bigtreetech/BIGTREETECH-EZ-Driver/BIGTREETECH EZ5160RGB/Hardware/TOP-Pin.png

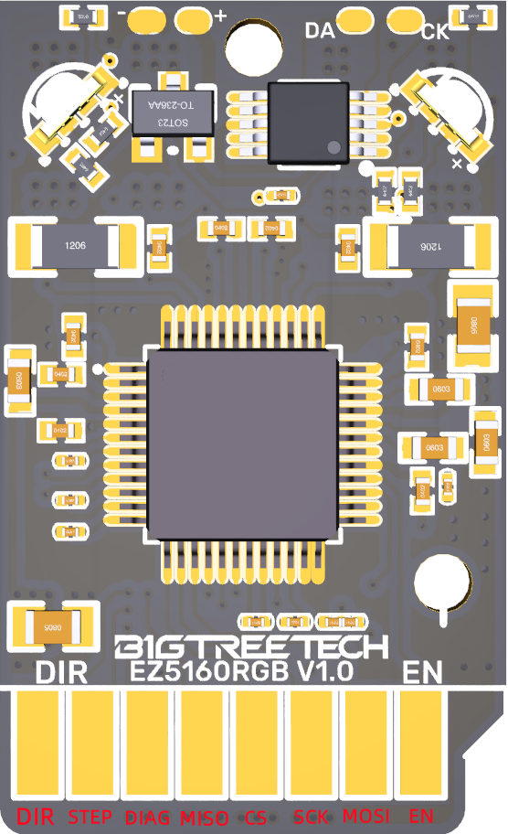
BIGTREETECH EZ5160RGB/Hardware/TOP-Pin.png
