bigtreetech/BIGTREETECH-EZ-Driver/BIGTREETECH EZ5160 Pro V1.0/Bot-Pin.png

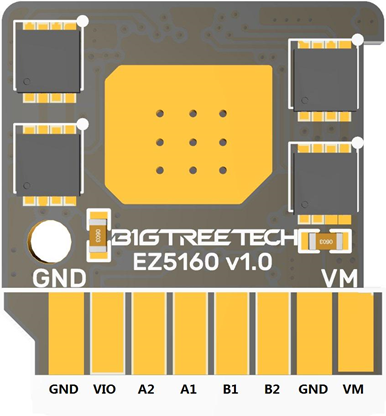
BIGTREETECH EZ5160 Pro V1.0/Bot-Pin.png
