bigtreetech/BIGTREETECH-EZ-Driver/BIGTREETECH EZ5160RGB/Hardware/BIGTREETECH EZ5160RGB V1.0用户手册.pdf

## 深圳市必趣科技有限公司 BIGTREETECH

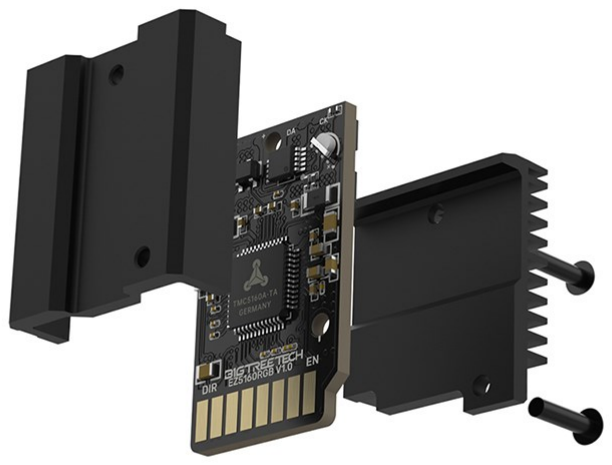
[picture p3: figure]

1 / 11

# BIGTREETECH

# EZ5160RGB V1.0

# 使用说明

## BIGTREETECH

2 / 11

目录

## BIGTREETECH

3 / 11

## 修订历史

版本 | 修改说明 | 日期
01.00 | 初稿 | 2023/04/15

## BIGTREETECH

4 / 11

## 一、产品简介

EZ5160 RGB 是一款大功率的步进电机驱动控制模块，外置 8 个功率 MOS 管，最大电压可 达 56V，支持的步进电机范围更广，适配性更高。

### 1.1 产品特点

1. 采用外置 8 个功率 MOS 管，可支持最大电压 VM=56V，最大电流 IRMS=4.7A，正弦波峰 值电流=6.6A；
2. 超静音模式；
3. 发热远远低于 2100、2130 等驱动；
4. 能防止电机抖动；
5. 不易失步；
6. 可驱动 57 步进电机；
7. 采用新研发的板框，匹配新的连接器，让客户体验美感的同时，避免旧驱动针脚扎伤 手的事故发生；
8. 采用新型定制的散热片，增强散热能力的同时，保护驱动芯片不受外部的伤害；
9. 板载 RGB 灯和热敏电阻测温，实时感知模块温度，并通过 RGB 灯状态传递温度信息。

### 1.2 产品参数

1. 外观尺寸： 18.5*30.47mm
2. 驱动芯片： TMC5160-TA
3. 输入电压（VM）： 8V-56V
4. 最大电流：4.7A，正弦波峰值电流 6.6A
5. 最大细分：256
6. 工作模式：SPI
7. R sensor: 50mΩ

## BIGTREETECH

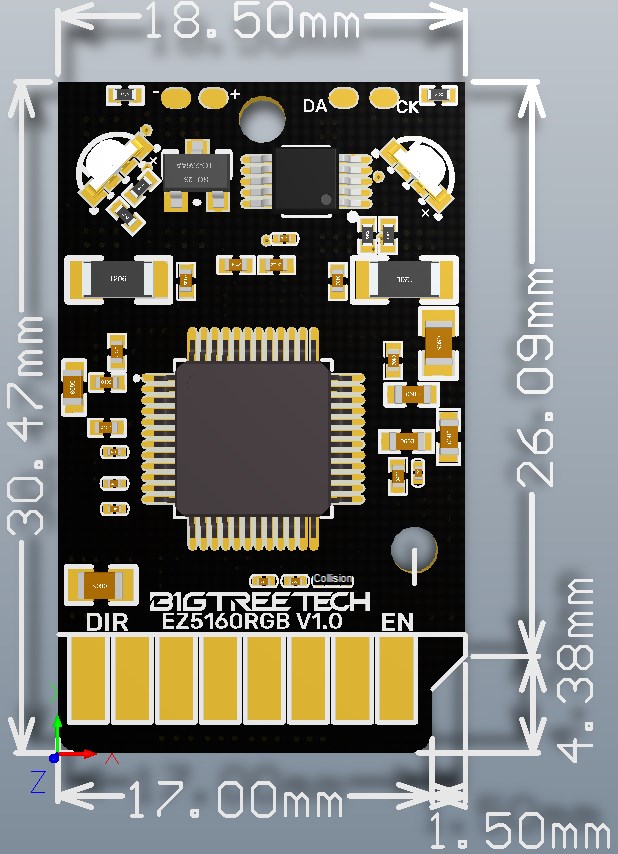
[picture p4: figure]

5 / 11

### 1.3 外设接口

### 1.3.1 尺寸图

## BIGTREETECH

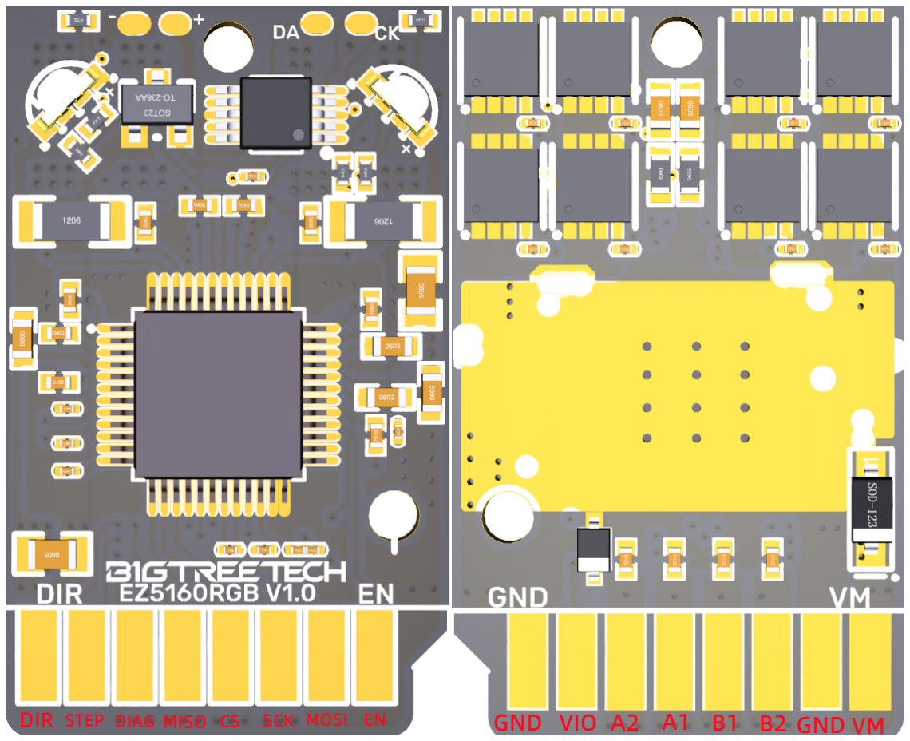
[picture p5: figure]

6 / 11

### 1.3.2 接口示意图

功能 | 功能
（EN）使能 | （VM）电机供电电压
（SDI/CFG1）数据 | （GND）接地
（SCK/CFG2）时钟 | （B2）B 相
（CSN/CFG3）片选 | （B1）B 相
（SDO/CFG0）数据 | （A1）A 相
（DIAG）堵转检测 | （A2）A 相
（STEP）脉冲输入 | （VIO）逻辑电压
（DIR）方向输入 | （GND）接地

## BIGTREETECH

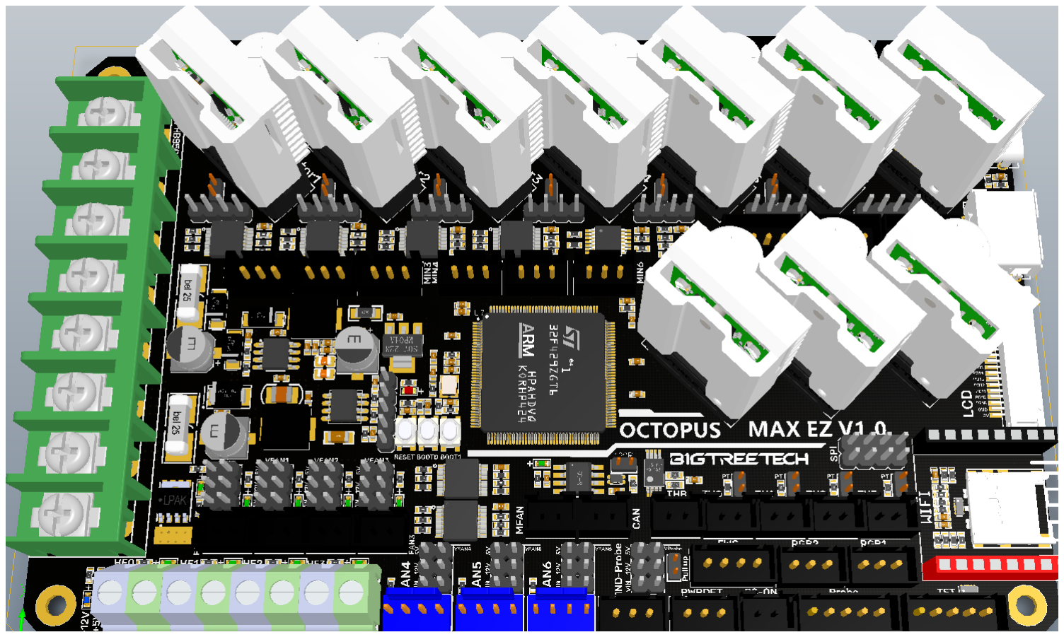
[picture p6: figure]

7 / 11

## 二、接口介绍

### 2.1 安装方式

EZ 版本驱动安装到新座子方向如下图所示（Octopus MAX EZ + EZ5160RGB）：

### 2.2 RGB 灯状态说明

温度处于 40°C 以下时，RGB 灯亮蓝色；
温度从 40°C 上升到 75°C 时，RGB 蓝色亮度逐渐减弱，红色亮度逐渐增强，色调由蓝色 渐变为紫色，然后渐变为洋红色；

温度处于 75°C 以上时，RGB 灯亮红色。

## BIGTREETECH

## 三、固件设置

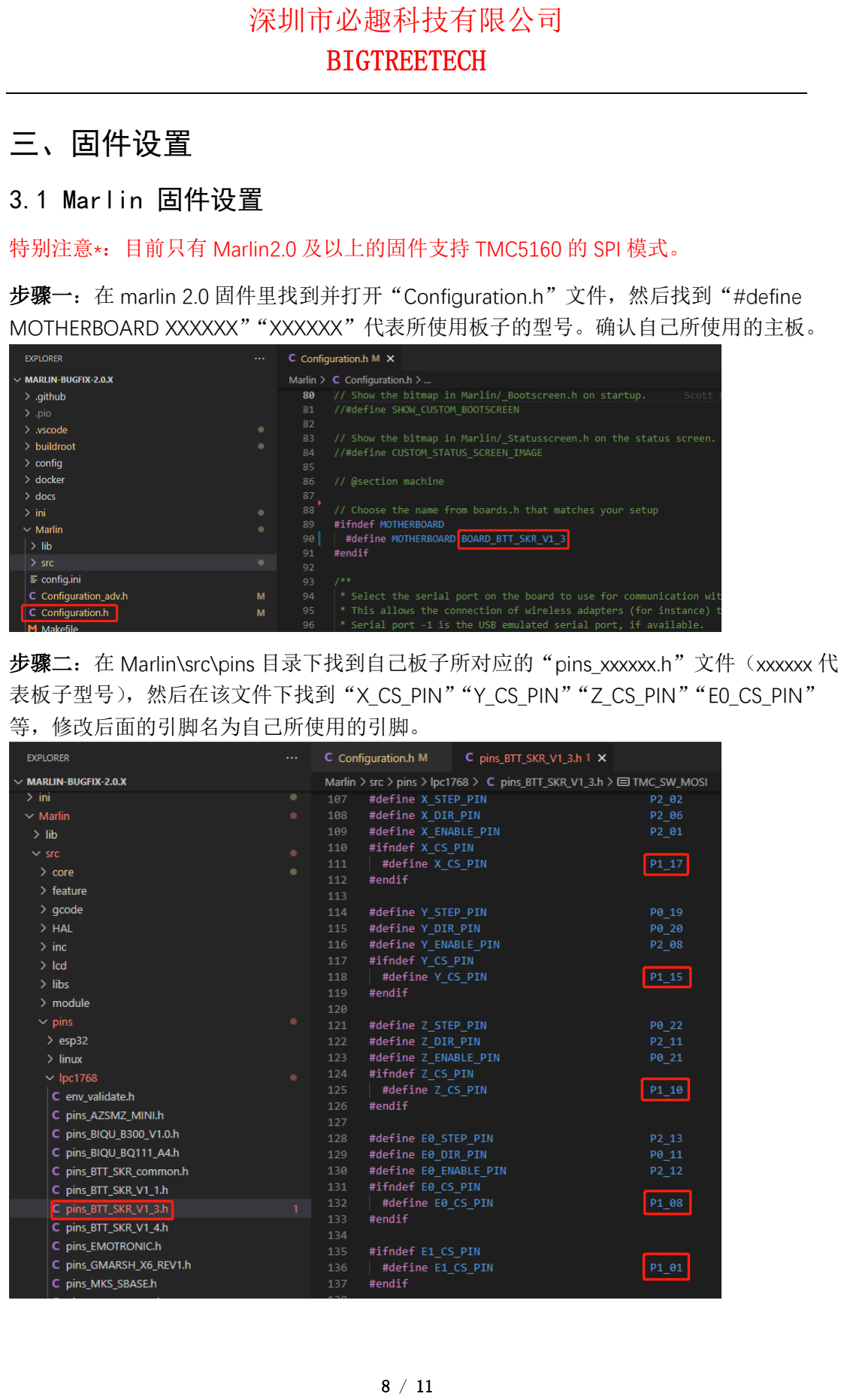
[picture p7: page 8]

8 / 11

### 3.1 Marlin 固件设置

特别注意*：目前只有 Marlin2.0 及以上的固件支持 TMC5160 的 SPI 模式。

步骤一：在 marlin 2.0 固件里找到并打开“Configuration.h”文件，然后找到“#define MOTHERBOARD XXXXXX”“XXXXXX”代表所使用板子的型号。确认自己所使用的主板。

步骤二：在 Marlin\src\pins 目录下找到自己板子所对应的“pins_xxxxxx.h”文件（xxxxxx 代 表板子型号），然后在该文件下找到“X_CS_PIN”“Y_CS_PIN”“Z_CS_PIN”“E0_CS_PIN” 等，修改后面的引脚名为自己所使用的引脚。

## BIGTREETECH

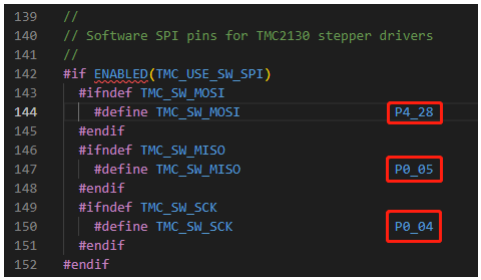
[picture p8: figure]
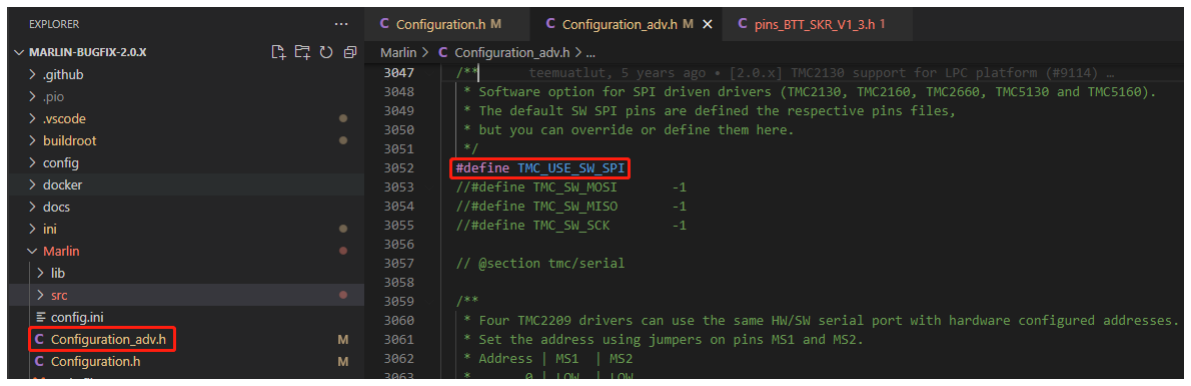
[picture p9: figure]

9 / 11

步骤三：在步骤二的文件下找到“#define TMC_SW_MOSI XXX”“#define TMC_SW_MISO XXX”“#define TMC_SW_SCK XXX”将“XXX”修改为自己所要使用的引 脚。

步骤四：找到并打开“Configuration_adv.h”,然后找到“#define TMC_USE_SW_SPI” 去 掉屏蔽符“//”

## BIGTREETECH

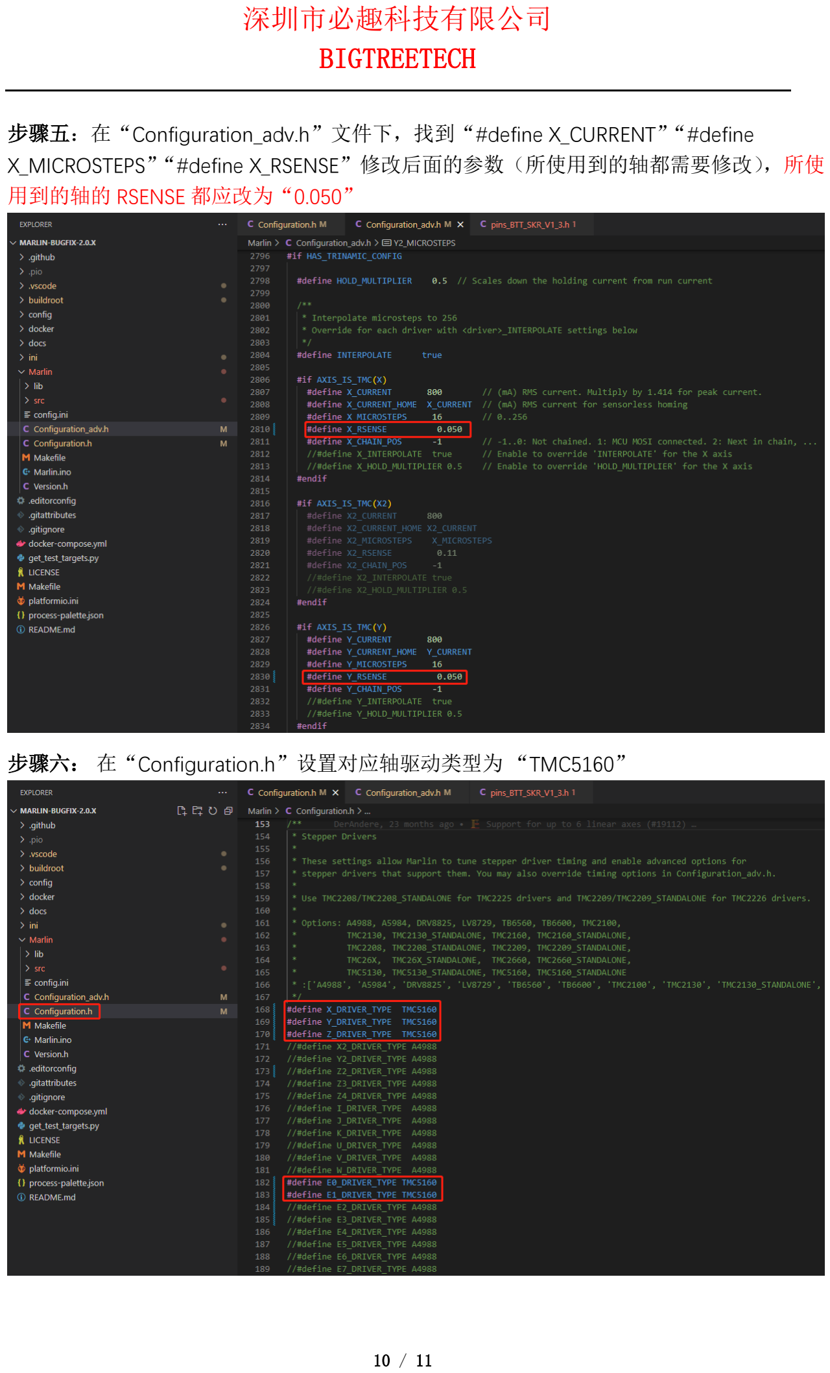
[picture p10: page 10]

10 / 11

步骤五：在“Configuration_adv.h”文件下，找到“#define X_CURRENT”“#define X_MICROSTEPS”“#define X_RSENSE”修改后面的参数（所使用到的轴都需要修改），所使 用到的轴的 RSENSE 都应改为“0.050”

步骤六： 在“Configuration.h”设置对应轴驱动类型为 “TMC5160”

## BIGTREETECH

11 / 11

### 3.2 Klipper 固件设置

[tmc5160 stepper_x]
cs_pin: P1.17
spi_software_miso_pin: P0.5 spi_software_mosi_pin: P4.28 spi_software_sclk_pin: P0.4 sense_resistor: 0.050
#diag1_pin: P1.29

run_current: 0.800
stealthchop_threshold: 999999
注意：Klipper 默认 sense_resistor 为 0.075，要设置为 0.050

## 四、注意事项

1. 安装驱动前一定要断开电源，防止驱动烧毁；
2. 请不要带电插拔驱动模块，以免造成损坏；
3. 我司出厂时已安装好散热片，请勿轻易拆除散热片，导热物质没有之后，散热效果会 降低；
4. 注意:使用高压（大于 48V）或者大电流（大于 2A）时，需采取主动散热以保证驱动可 以正常工作。

如果您还需要此产品的其他资源，可以到 https://github.com/bigtreetech/ 上自行查 找，如果无法找到您所需的资源，可以联系我们的售后支持。

若您使用中还遇到别的问题，欢迎您联系我们，我们定会细心为您解答；若您对我们的产 品有什么好的意见或建议，也欢迎您回馈给我们，我们也会仔细斟酌您的意见或建议，感 谢您选择 BIGTREETECH 制品，谢谢！
