bigtreetech/BIGTREETECH-EZ-Driver/BIGTREETECH EZ5160 Pro V1.0/Top-Pin.png

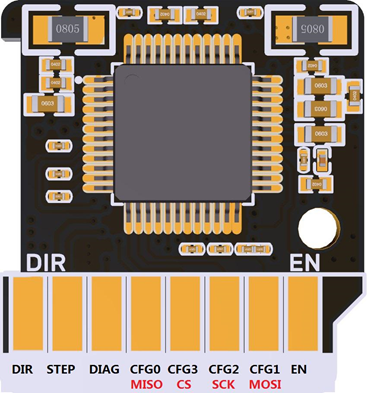
BIGTREETECH EZ5160 Pro V1.0/Top-Pin.png
