bigtreetech/BIGTREETECH-EZ-Driver/BIGTREETECH EZ5160RGB/Hardware/bot-Pin.png

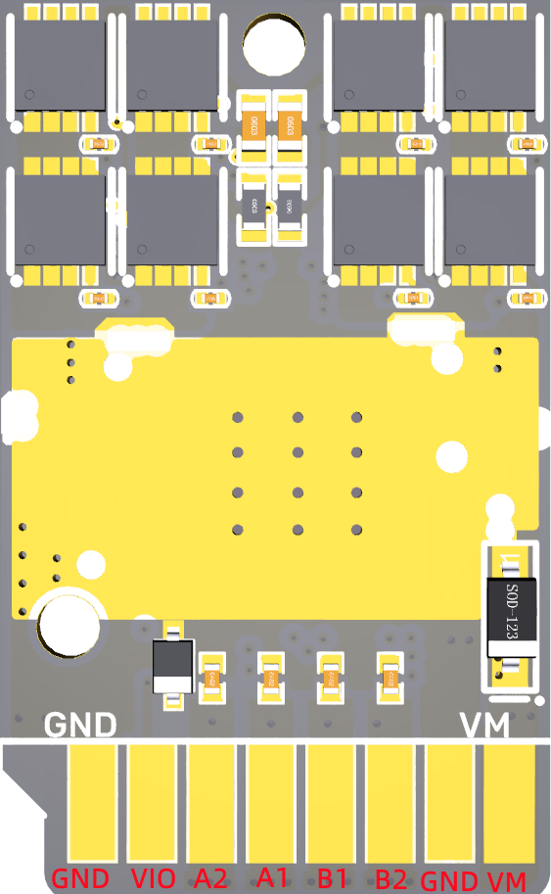
BIGTREETECH EZ5160RGB/Hardware/bot-Pin.png
