bigtreetech/BIGTREETECH-EZ-Driver/BIGTREETECH EZ2130 V1.0/3D/BIGTREETECH EZ2130 V1.0.step

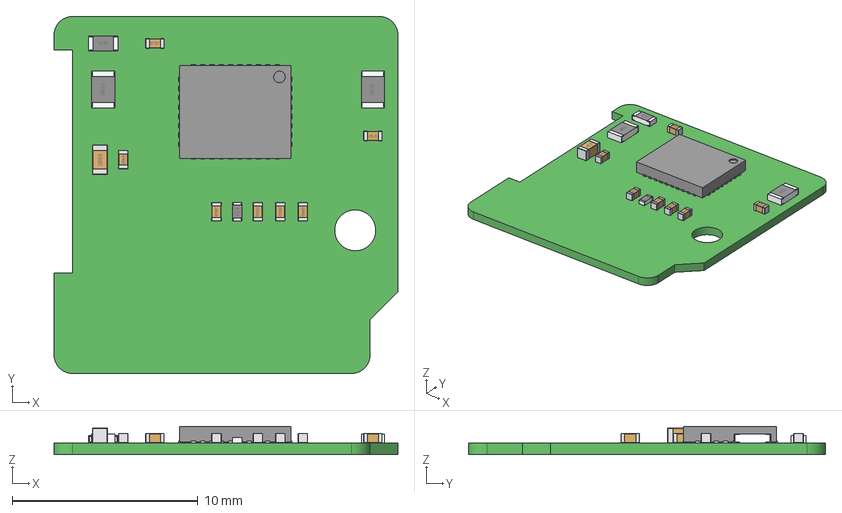
[picture p13: CAD file, 2022-06-20]
BIGTREETECH EZ2130 V1.0/3D/BIGTREETECH EZ2130 V1.0.step
18.5 x 19.2 x 1.52 mm
ThermalPin
PinsArrayLR
PinsArrayTB
R_0603
LOGO? x 12
R_0805 x 2
R_0402
C_0402 x 7
C_0603
