bigtreetech/BIGTREETECH-EZ-Driver/BIGTREETECH EZ2208 V1.0/BIGTREETECH EZ2208 V1.0.step

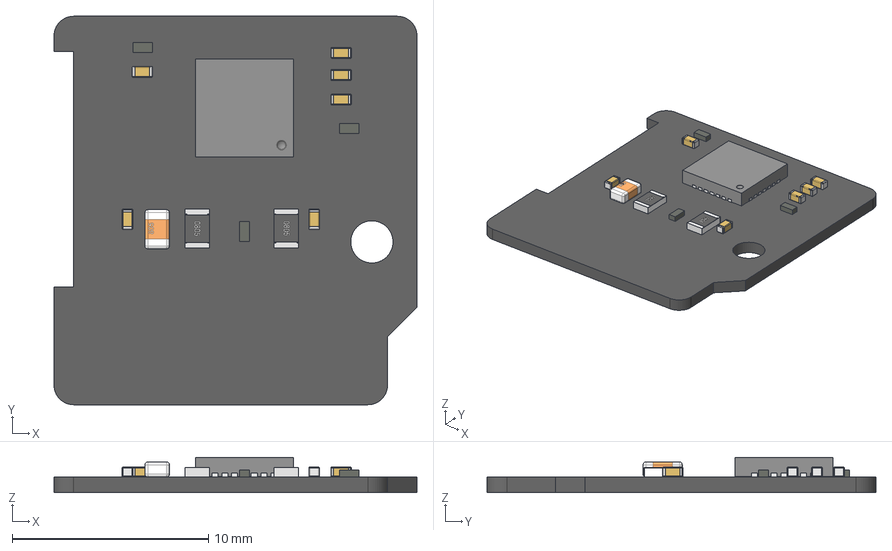
[picture p14: CAD file, 2022-06-20]
BIGTREETECH EZ2208 V1.0/BIGTREETECH EZ2208 V1.0.step
18.5 x 19.8 x 1.80 mm
Board
Open_CASCADE_STEP_translator_6.8_2.1.1 x 6
Open_CASCADE_STEP_translator_6.8_2.1.2 x 6
Open_CASCADE_STEP_translator_6.8_2.2.1 x 6
Extruded x 3
User_Library-0805_SMD_Capacitor
User_Library-R_0805 x 2
User_Library-QFN28-0_5_Fusion
User_Library-QFN28-0_5_Fillet
