bigtreetech/BIGTREETECH-EZ-Driver/BIGTREETECH EZ2225 V1.0/3D/BIGTREETECH EZ2225 V1.0.step

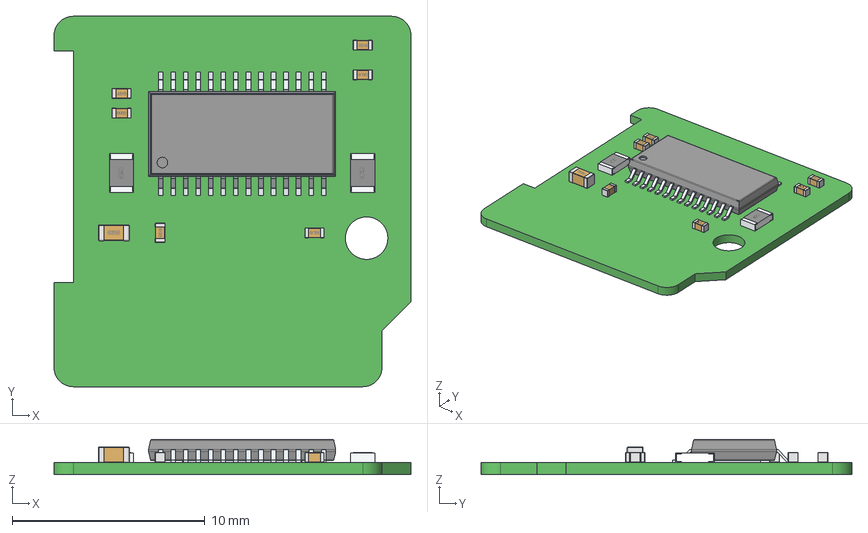
[picture p15: CAD file, 2022-06-20]
BIGTREETECH EZ2225 V1.0/3D/BIGTREETECH EZ2225 V1.0.step
18.5 x 19.2 x 1.82 mm
PinsArrayLR
ThermalPad
R_0805 x 2
LOGO? x 9
C_0402 x 6
C_0603
