bigtreetech/BIGTREETECH-EZ-Driver/BIGTREETECH EZ6609 V1.0/3D/BIGTREETECH EZ6609 V1.0.step

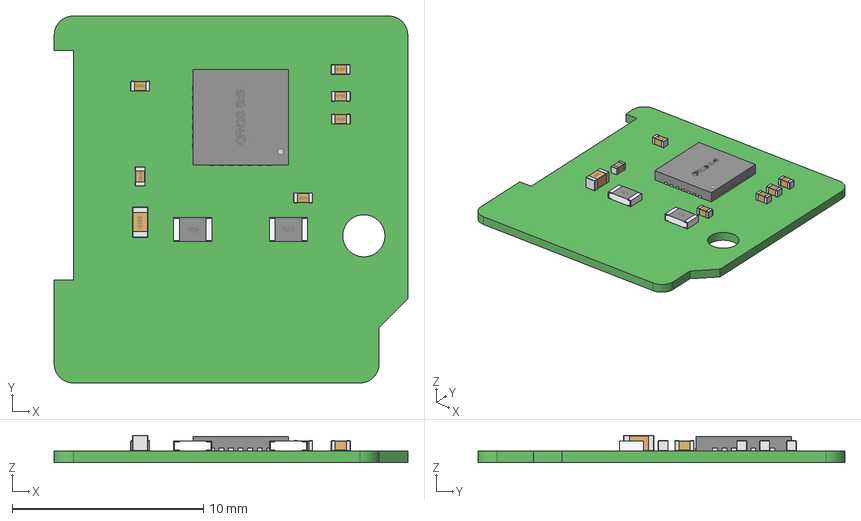
[picture p16: CAD file, 2022-06-20]
BIGTREETECH EZ6609 V1.0/3D/BIGTREETECH EZ6609 V1.0.step
18.5 x 19.2 x 1.43 mm
LOGO? x 9
C_0603
QFN28-5X5_呿极
QFN40_竘褐 x 64
LOGO?0.25
R_0805 x 2
C_0402 x 6
