bigtreetech/BIGTREETECH-EZ-Driver/(list of files, cad)

Other CAD files:
BIGTREETECH EZ2226 V1.0/3D/BIGTREETECH EZ2226 V1.0.step
BIGTREETECH EZZ2209 V1.0/BIGTREETECH EZ2209 V1.0.step
