bigtreetech/BIGTREETECH-EZ-Driver/BIGTREETECH EZ5160 Pro V1.0/BIGTREETECH EZ5160 V1.0 User Manual.pdf

## BIGTREETECH

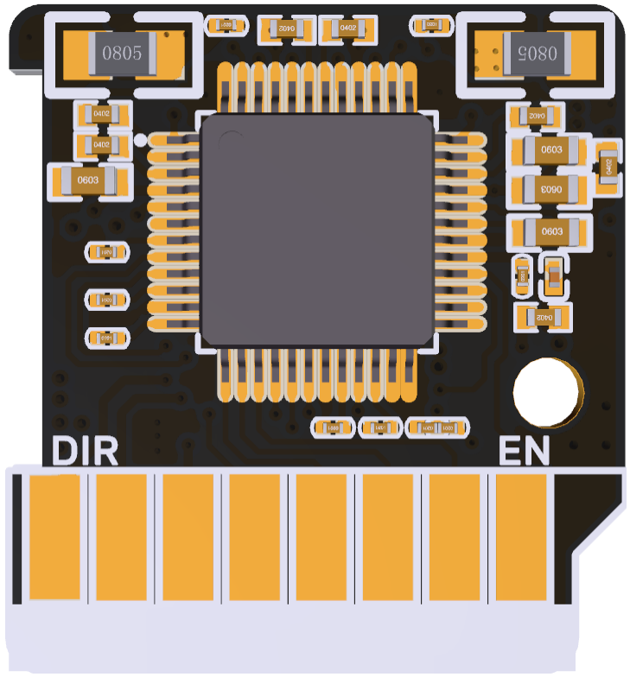
[picture p17: figure]

1 / 13

# BIGTREETECH

# EZ5160 V1.0

# User Manual

## Contents

## BIGTREETECH

2 / 13

Revision History | 3
1. Product Introduction | 4
1.1 Product Features | 4
1.2 Product Parameters | 4
1.3 Peripheral Interface | 5
1.3.1Product Dimensions | 5
1.3.2 Interface Diagram | 6
2. Interface Introduction | 7
2.1 Installation Method and Interface | 7
3. Firmware Settings | 8
3.1 Marlin Firmware Settings | 8
4. Precautions | 122

## BIGTREETECH

3 / 13

## Revision History

Version | Revision Description | Date
01.00 | First Draft | 2022/03/17

## BIGTREETECH

4 / 13

## 1. Product Introduction

TMC5160 is a high-power stepper motor drive control chip, with an external MOSFET, its maximum voltage can reach 48V, thus the supported stepper motor range is wider, and the adaptability is higher.

### 1.1 Product Features

1. With the external MOSFET, it can support higher voltage and larger current, and the maximum current can reach 8A (because the module is limited by size and connector, the current cannot exceed 3A);
2. Ultra-quiet mode;
3. Low heat generation, which is far lower than that of 2100, 2130, and other drivers;
4. It can prevent the motor from shaking;
5. Not easy to lose steps;
6. Can drive 57 stepper motors;
7. The newly developed board frame is used to match the new connector so that customers can experience the aesthetic feeling and avoid the accident of the old driving pin stabbing the hand;
8. Using a new type of specially made heat sink to enhance the heat dissipation as well as protect the driver chip from external damage;
9. Using the environmentally friendly packaging to improve the cost-effectiveness.

### 1.2 Product Parameters

1. Product Size: 18.5 x 20mm
2. Driver Chip: TMC5160-TA
3. Input Voltage (VM): 8V-48V
4. Maximum Current: 2.5A, Peak Value: 3A (the maximum current that the header can withstand.)
5. Maximum Subdivision: 256
6. Working Mode: SPI

## BIGTREETECH

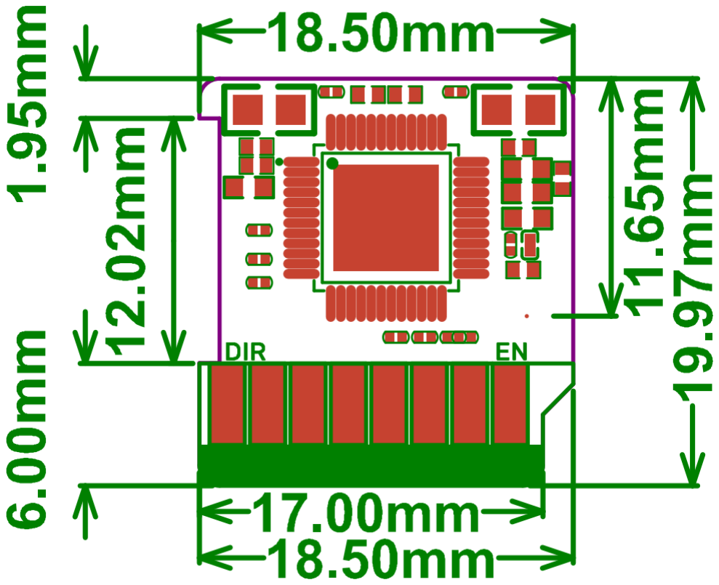
[picture p18: figure]

5 / 13

### 1.3 Peripheral Interface

### 1.3.1 Product Dimensions

## BIGTREETECH

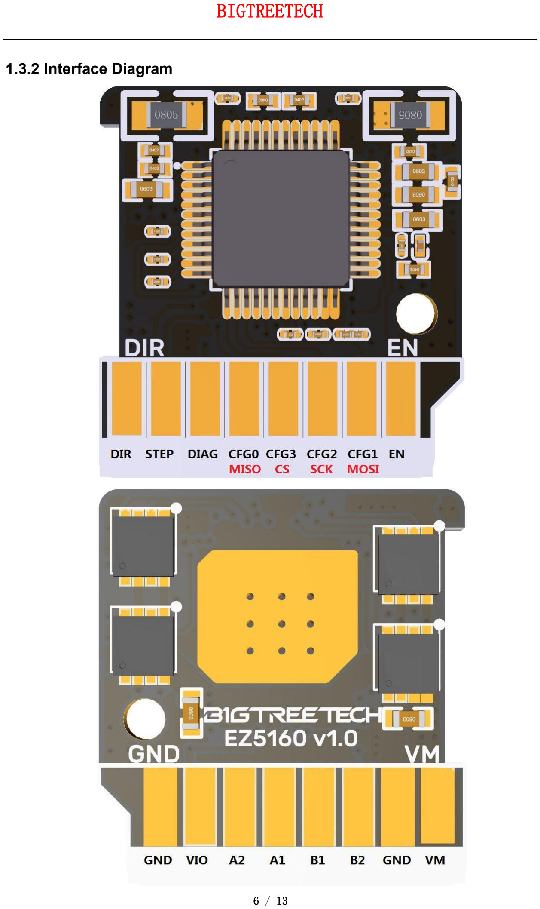
[picture p19: page 6]

6 / 13

### 1.3.2 Interface Diagram

## BIGTREETECH

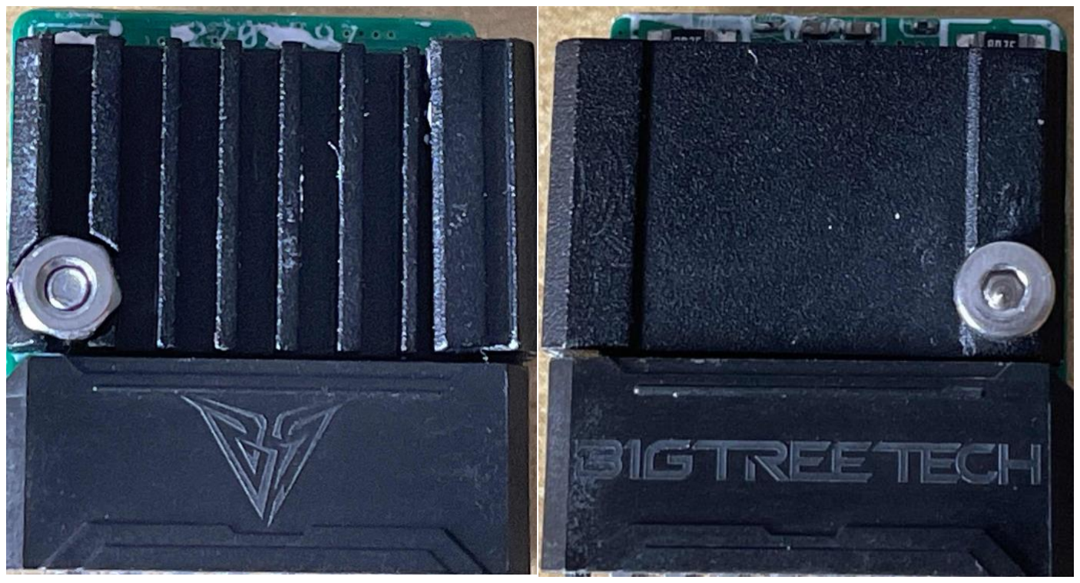
[picture p20: figure]

7 / 13

## 2. Interface Introduction

### 2.1 Installation Method and Interface

The direction of installing the EZ version driver to the new header is shown in the image below:

J1 | Function | J2 | Function
1 | (EN) Enable | 1 | (VM) Motor Supply Voltage
2 | (SDI/CFG1) Data | 2 | (GND) GND
3 | (SCK/CFG2) Clock | 3 | (B2) B Phase
4 | (CSN/CFG3) Chip Select | 4 | (B1) B Phase
5 | (SDO/CFG0) Data | 5 | (A1) A Phase
6 | (DIAG) Locked-Rotor Detection | 6 | (A2) A Phase
7 | (STEP) Pulse Input | 7 | (VIO) Logic Voltage
8 | (DIR) Direction Input | 8 | (GND) GND

## BIGTREETECH

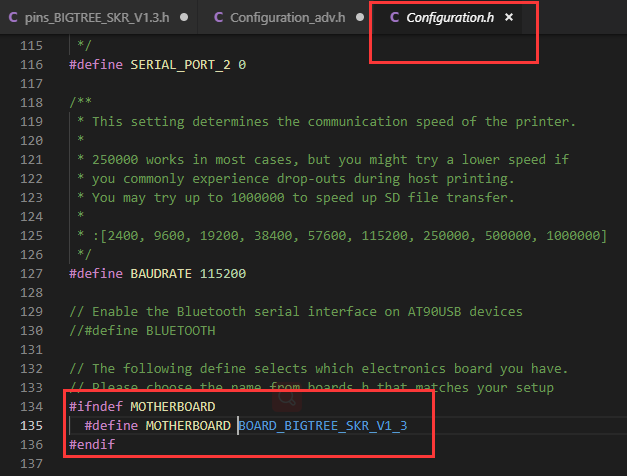
[picture p21: figure]

8 / 13

## 3. Firmware Settings

### 3.1 Marlin Firmware Settings

Note*: Currently only the firmware of Marlin 2.0 and later supports the SPI mode of TMC5160.

Step 1: Find and open the "Configuration.h" file in the Marlin 2.0 firmware, then find "#define MOTHERBOARD XXXXXX", "XXXXX" represents the model of the board used. Check the motherboard you are using.
Step 2: Find the "pins_xxxxxx.h" file corresponding to your board in Marlin\src\pins (xxxx represents the board model), and then find "X_CS_PIN", "Y_CS_PIN", "Z_CS_PIN", "EO_CS_PIN" etc., in the file, and modify the pin name to the pin you use.

## BIGTREETECH

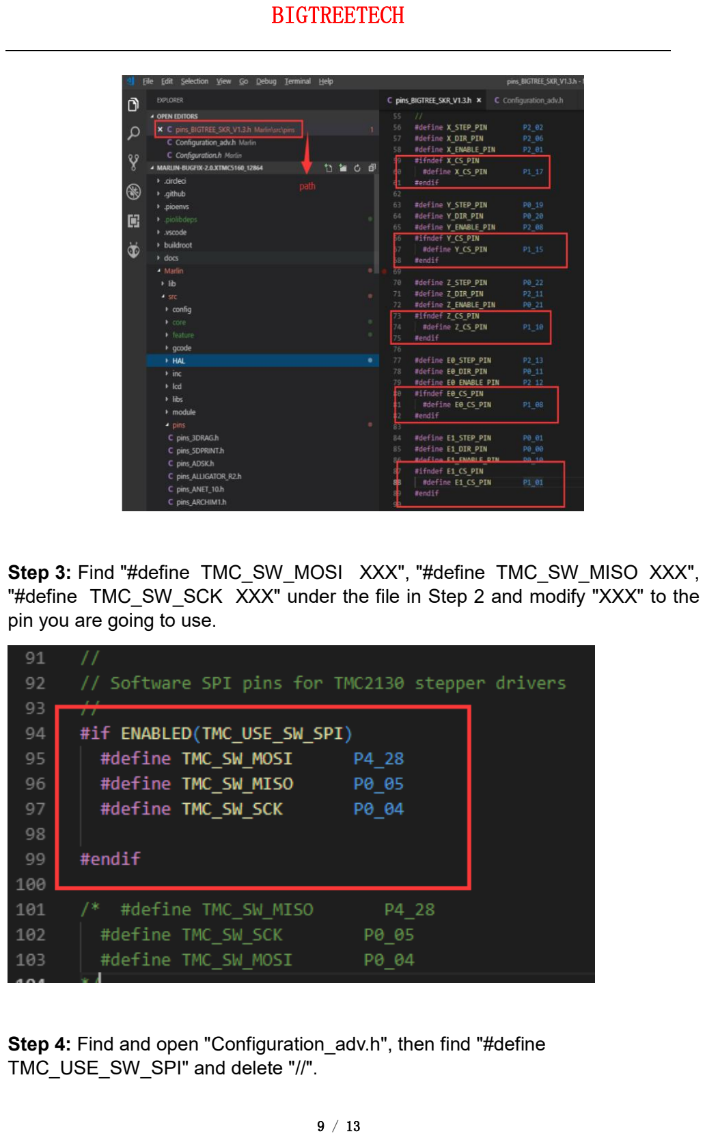
[picture p22: page 9]

9 / 13

Step 3: Find "#define TMC_SW_MOSI XXX", "#define TMC_SW_MISO XXX", "#define TMC_SW_SCK XXX" under the file in Step 2 and modify "XXX" to the pin you are going to use.
Step 4: Find and open "Configuration_adv.h", then find "#define TMC_USE_SW_SPI" and delete "//".

## BIGTREETECH

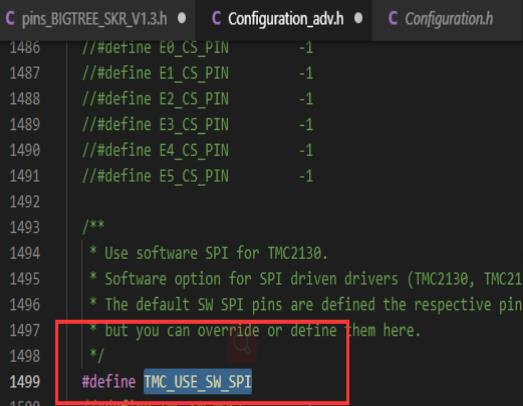
[picture p23: figure]

10 / 13

Step 5: In the "Configuration_adv.h" file, find "#define X_CURRENT", "#define X_MICROSTEPS", "#define X_RSENSE" and modify the following parameters, (all axes used need to be modified) the RSENSE of the axes used should be modified as "0.075".

## BIGTREETECH

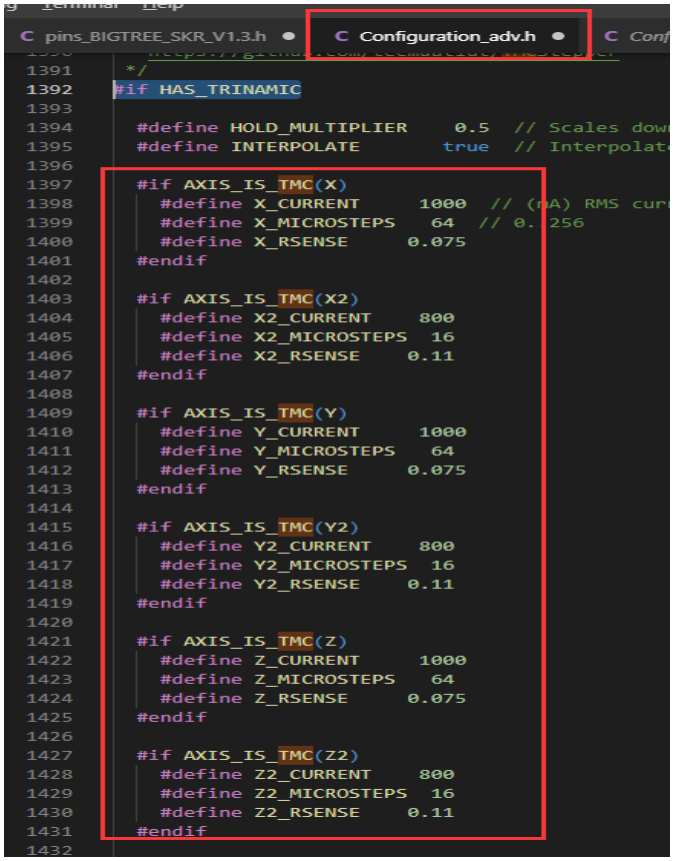
[picture p24: figure]

11 / 13

Step 6: After the modification of Step 5, find and open "Configuration.h" and then find "#define DEFAULT_AXIS_STEPS_PER_UNIT" and modify the following parameters to set the subdivision, the subdivision of this part must correspond to that of Step 5.

## BIGTREETECH

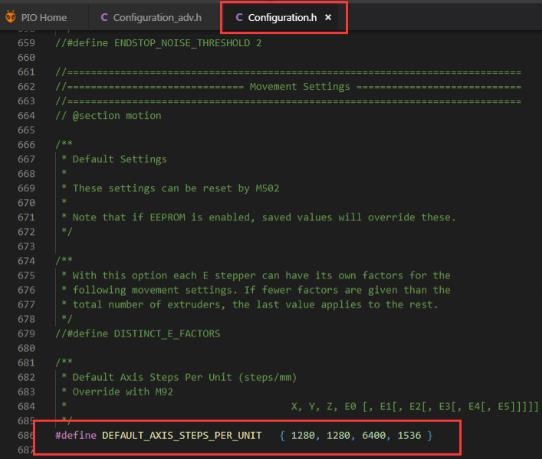
[picture p25: figure]

12 / 13

Subdivision Calculation Method: "80, 80, 400, 96" means 16 subdivision, if modified to 32 subdivision, that will be "80*(32/16), 80*(32/16) , 400*(32/16) , 96*(32/16) ".

The sampling resistance used in this product is 0.075R, so the effective value of the driving current of this product is 3A.

## 4. Precautions

1. Be sure to disconnect the power supply before installing the driver to prevent it from burning;
2. Before installing the driver, be sure to confirm the direction of the driver to prevent the driver from not working due to reverse connection;
3. Please do not plug and unplug the drive module with power on to avoid damage;

## BIGTREETECH

13 / 13

4. The product has installed the heat sink before leaving the factory， please don't remove it. If there is no thermal conductive material, the heat dissipation effect will be reduced；
5. Note: when using high voltage (more than 36V) or high current (more than 1.5A), active heat dissipation shall be taken to ensure that the drive can work normally.

For more information about this product, please visit https://github.com/bigtreetech/. If you cannot find the information you need, you can contact our after-sales support.

Please do not hesitate to contact us if you encounter other problems during use, we will answer your question carefully; Any suggestions/feedback on our products are welcome, and we will consider them carefully. Thanks for choosing BIGTREETECH.
