bigtreetech/BIGTREETECH-EZ-Driver/(threads)

Thread 1 (2022-07-14):

Lack of footprints for EZ Driver socket.

SteveJWallace, 2022-07-14:
There are no footprints available for the EZ Driver socket for KiCad or other EDA software. There are no specifications to use to create footprints from. This will prevent hobbyists from embracing the socket.

Fisheiyy, 2022-08-07:
I second this, a footprint for KiCad would be great.

Fisheiyy, 2022-08-07:
> There are no footprints available for the EZ Driver socket for KiCad or other EDA software. There are no specifications to use to create footprints from. This will prevent hobbyists from embracing the socket.

I created my own footprint/symbol for KiCad
[BTT_EZDRIVER_SOCKET.zip](https://github.com/bigtreetech/BIGTREETECH-EZ-Driver/files/9276693/BTT_EZDRIVER_SOCKET.zip)

Thread 2 (2022-09-07):

VS rail shorted to ground through MLCC.

BenChung, 2022-09-07:
I'm helping someone who observed a EZ2209 make a loud pop and emit flame while powered on by examining their EZ2209 to try and determine a root cause of the failure.

These images show the state of the driver after the heatsink was removed and initial cleaning:
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

Notably, the VS tracks have been largely vaporized with damage particularly on the pin 28 side of the board (towards the square cutout side). I further investigated C3 as a potential cause of the issue, as the positive side of the capacitor and its trace appears to have been completely destroyed with the opposing ground plane also blown off. The following image shows the state of C3 while in-situ:
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

Based on the apparent damage to C3 (missing a corner of the capacitor body besides the contact), I desoldered C3 and flipped it over to examine the corner that appeared to have been destroyed:

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

Considerable destruction of the capacitor body is observed. Note that the ground-side electrode separated from the MLCC while it was removed. In particular, the corner of the capacitor close to the camera exhibits considerable carbonization and is no longer geometrically intact. This supports a hypothesis that the failure was caused by a short to ground from VS through C3 caused by stress cracking originating at a corner of the VS side of the capacitor shearing the electrodes. Under this hypothesis, the damage to the capacitor (and the rest of the PCB) would be caused by the resulting large fault current as the motor capacitor discharging through the shorted electrodes in the capacitor, explaining the asymmetric damage to the capacitor centered near one of the contacts.

I suspect that this failure was caused by either mechanical force applied during assembly or through flexing of the PCB at some point during assembly, shipping, or installation. Based on this, redesign of the heatsink to redistribute mechanical loads away from the PCB, use of a flexible termination MLCC, or moving the MLCC away from potential load paths may address the issue.

Thread 5 (2023-09-12):

Reference of EZ driver connector

kingovchouffe, 2023-09-12:
I would like to had the EZ driver connector on my own PCB for a robot project, does it have a number part or manufactor reference ?

Thread 6 (2023-11-25):

How to disable DIAG pin

norston, 2023-11-25:
I'm pretty sure the DIAG pin on the EZ2209 driver is causing my endstops not to trigger (or stay triggered, depending on which state I choose (high or low), while using the internal pullup - Marlin fw). On your TMC2201V1.2 you talk about this exact issue and your solution is to cut the DIAG pin. I'm using an Octopus MAX EZ with your EZ2209 drivers, so there is no pin to cut. Any suggestions on how to disable this pin?
