bigtreetech/BIGTREETECH-EZ-Driver/BIGTREETECH EZ2225 V1.0/Hardware/BIGTREETECH EZ2225 V1.0-SIZE.pdf

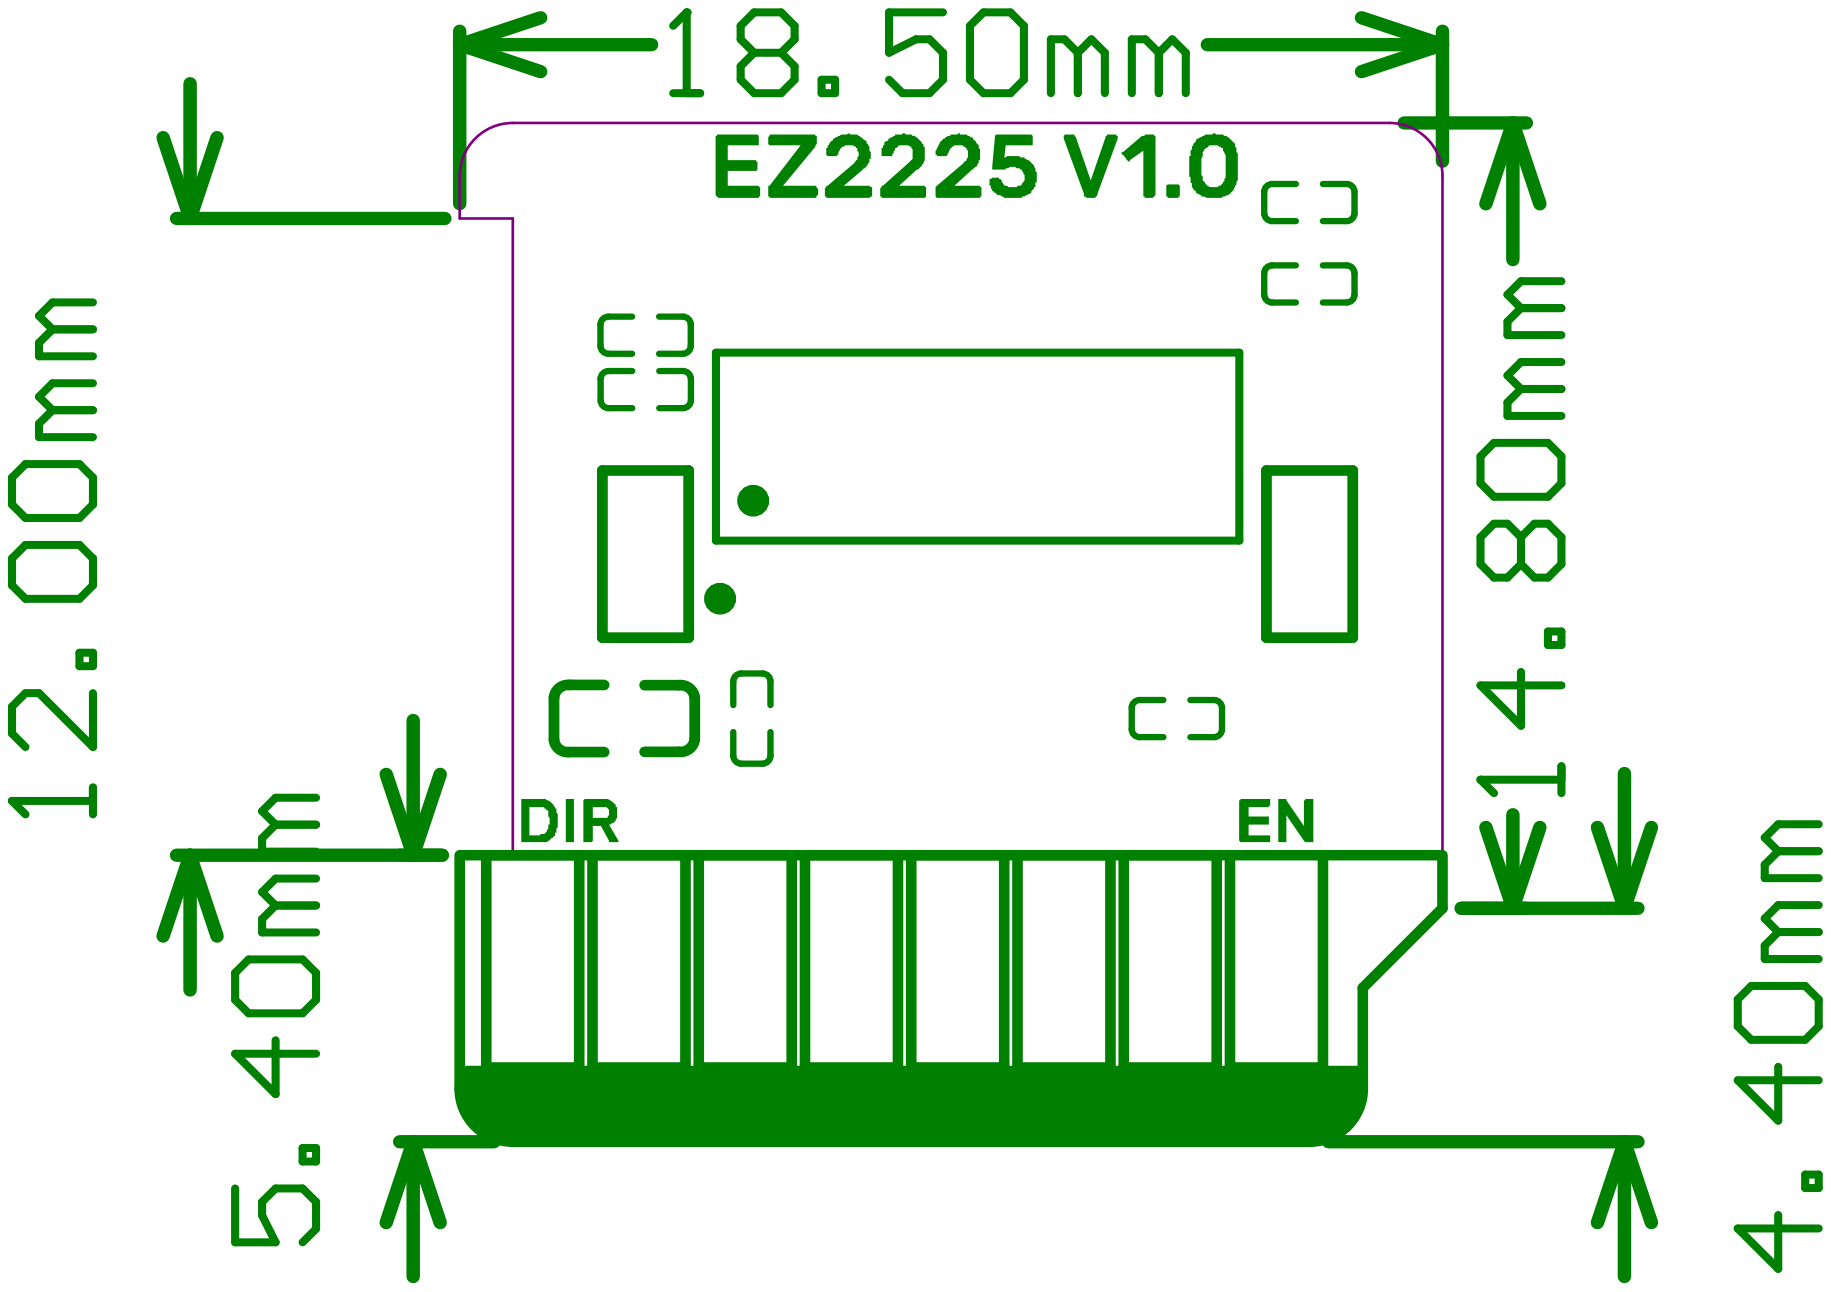
[picture p42: page 1]
