bigtreetech/BIGTREETECH-EZ-Driver/BIGTREETECH EZ2130 V1.0/Hardware/BIGTREETECH EZ2130 V1.0-SCH.pdf

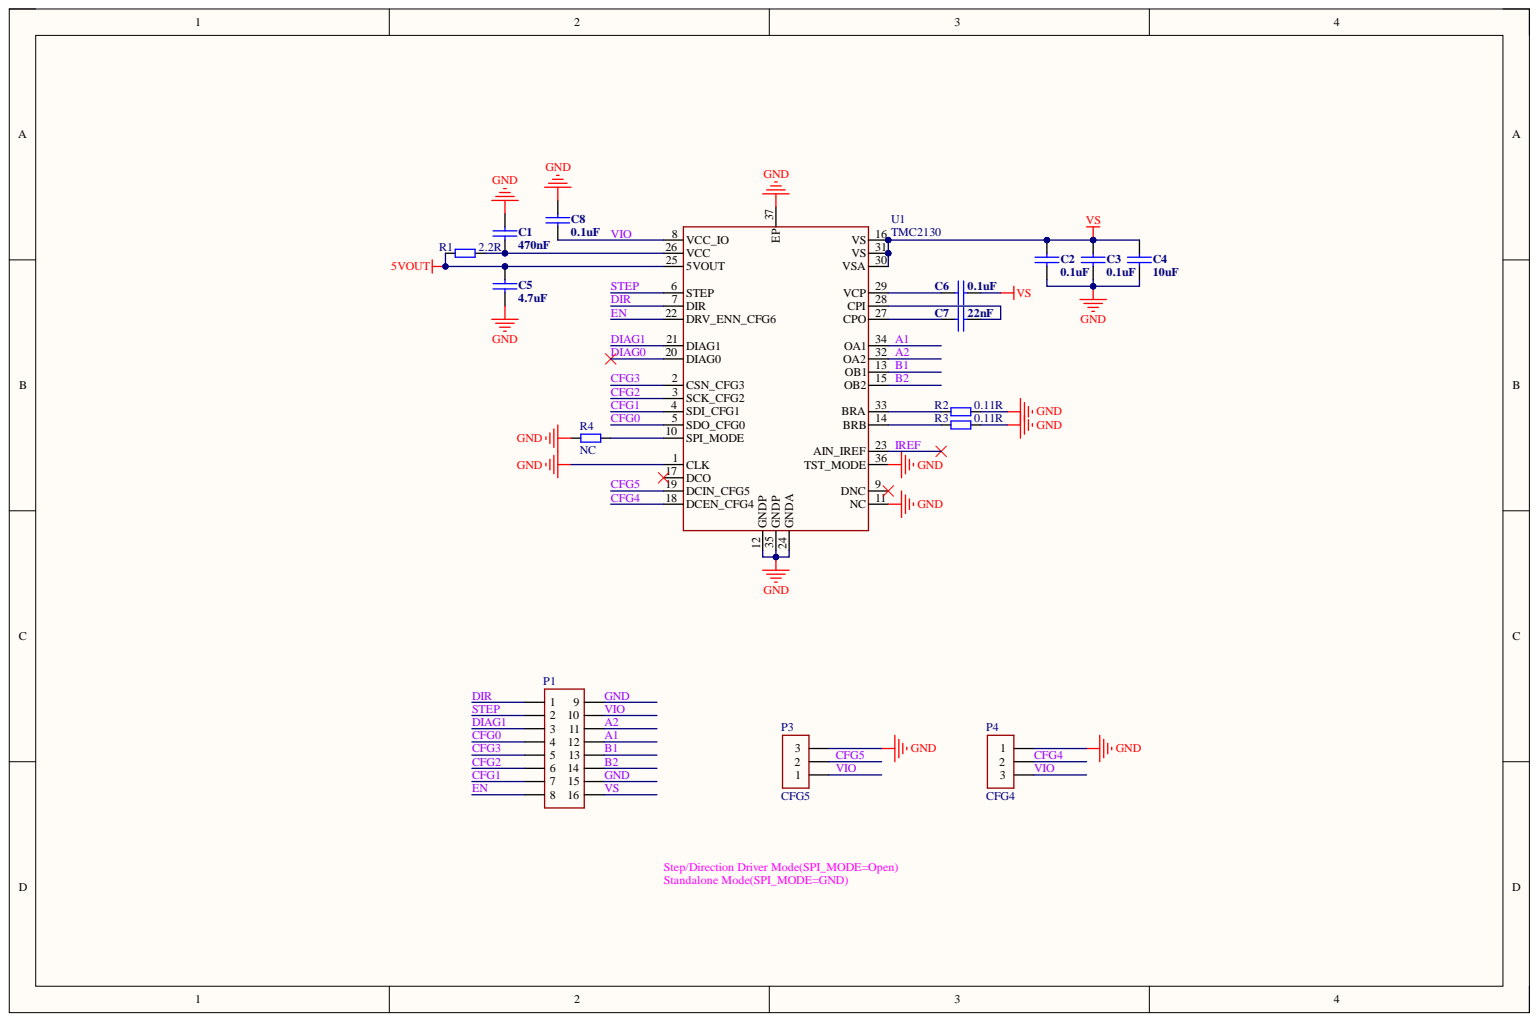
[picture p43: page 1]
