bigtreetech/BIGTREETECH-EZ-Driver/BIGTREETECH EZ2130 V1.0/Hardware/BIGTREETECH EZ2130 V1.0-SIZE.pdf

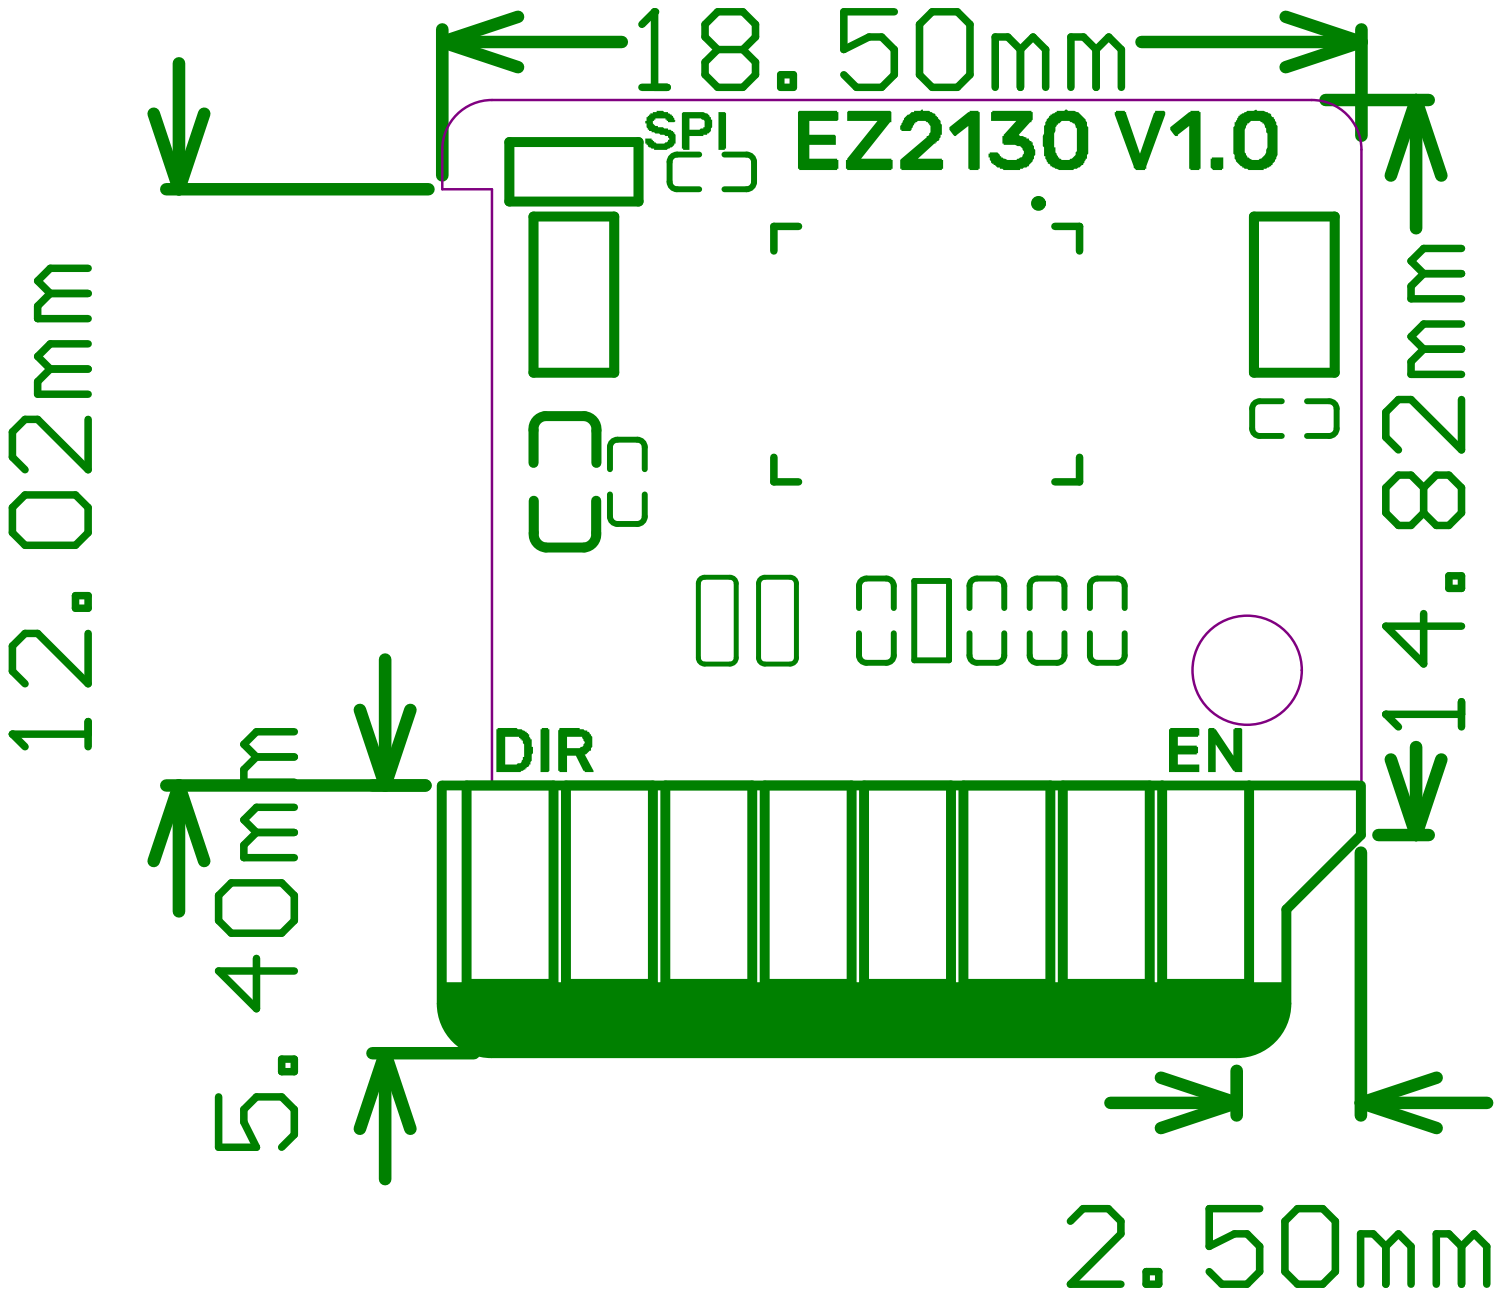
[picture p44: page 1]
