bigtreetech/BIGTREETECH-EZ-Driver/BIGTREETECH EZ5160 Pro V1.0/BIGTREETECH EZ5160 V1.0-BOT.pdf

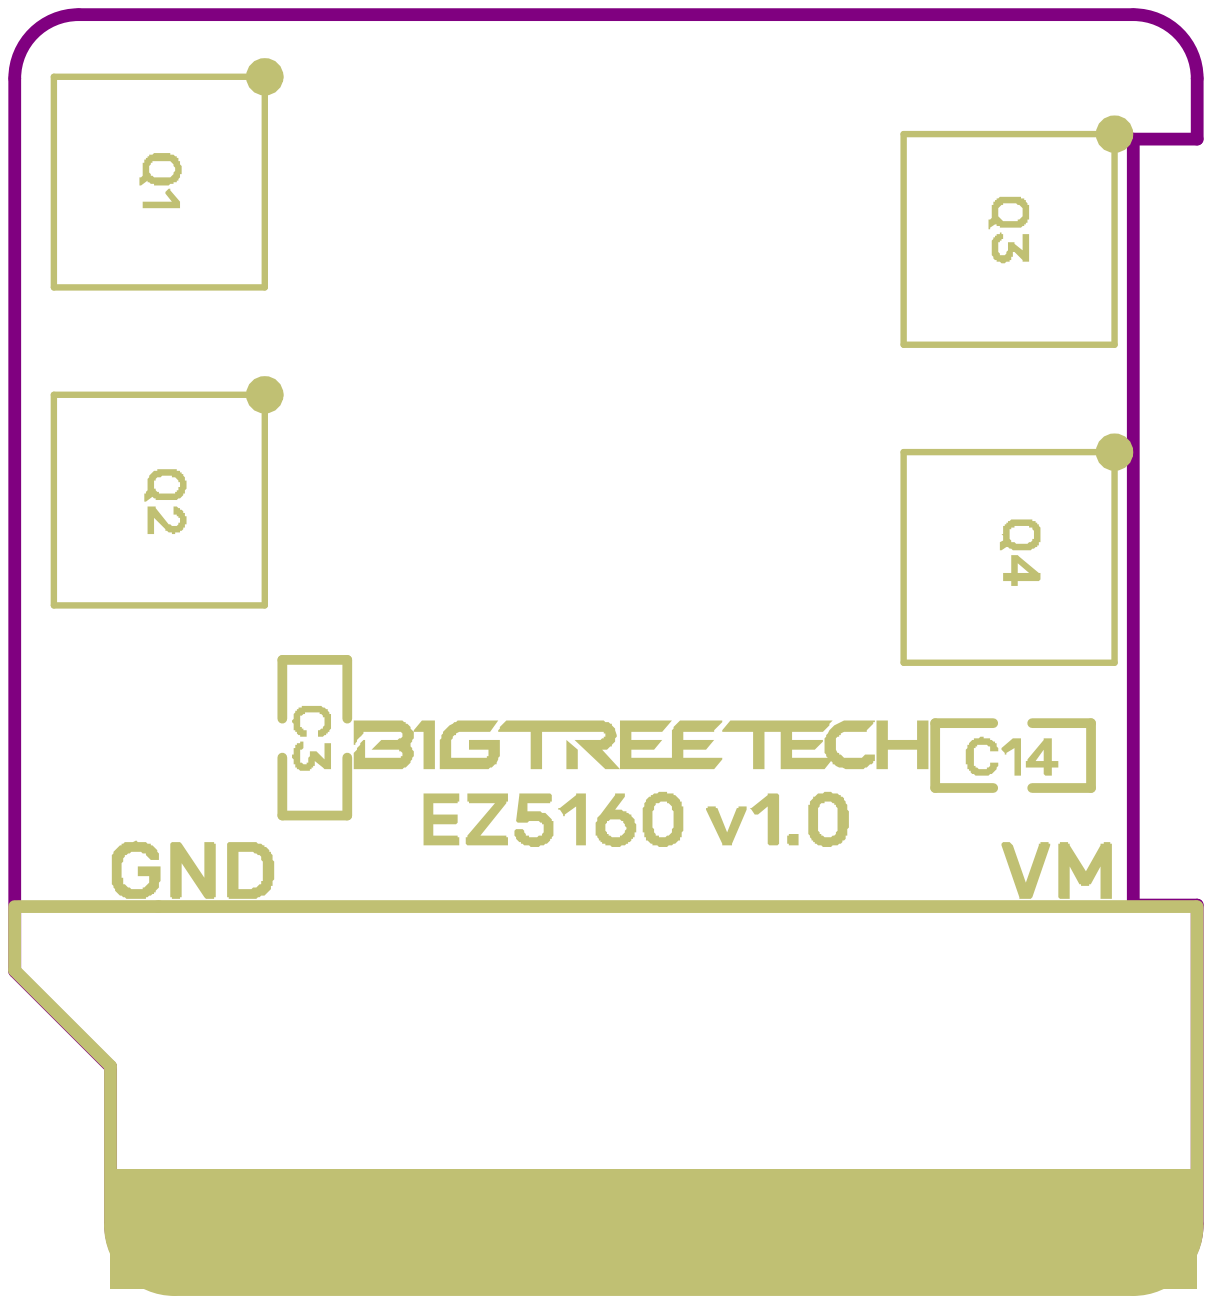
[picture p45: page 1]
