bigtreetech/BIGTREETECH-EZ-Driver/BIGTREETECH EZ5160 Pro V1.0/BIGTREETECH EZ5160 V1.0-SIZE.pdf

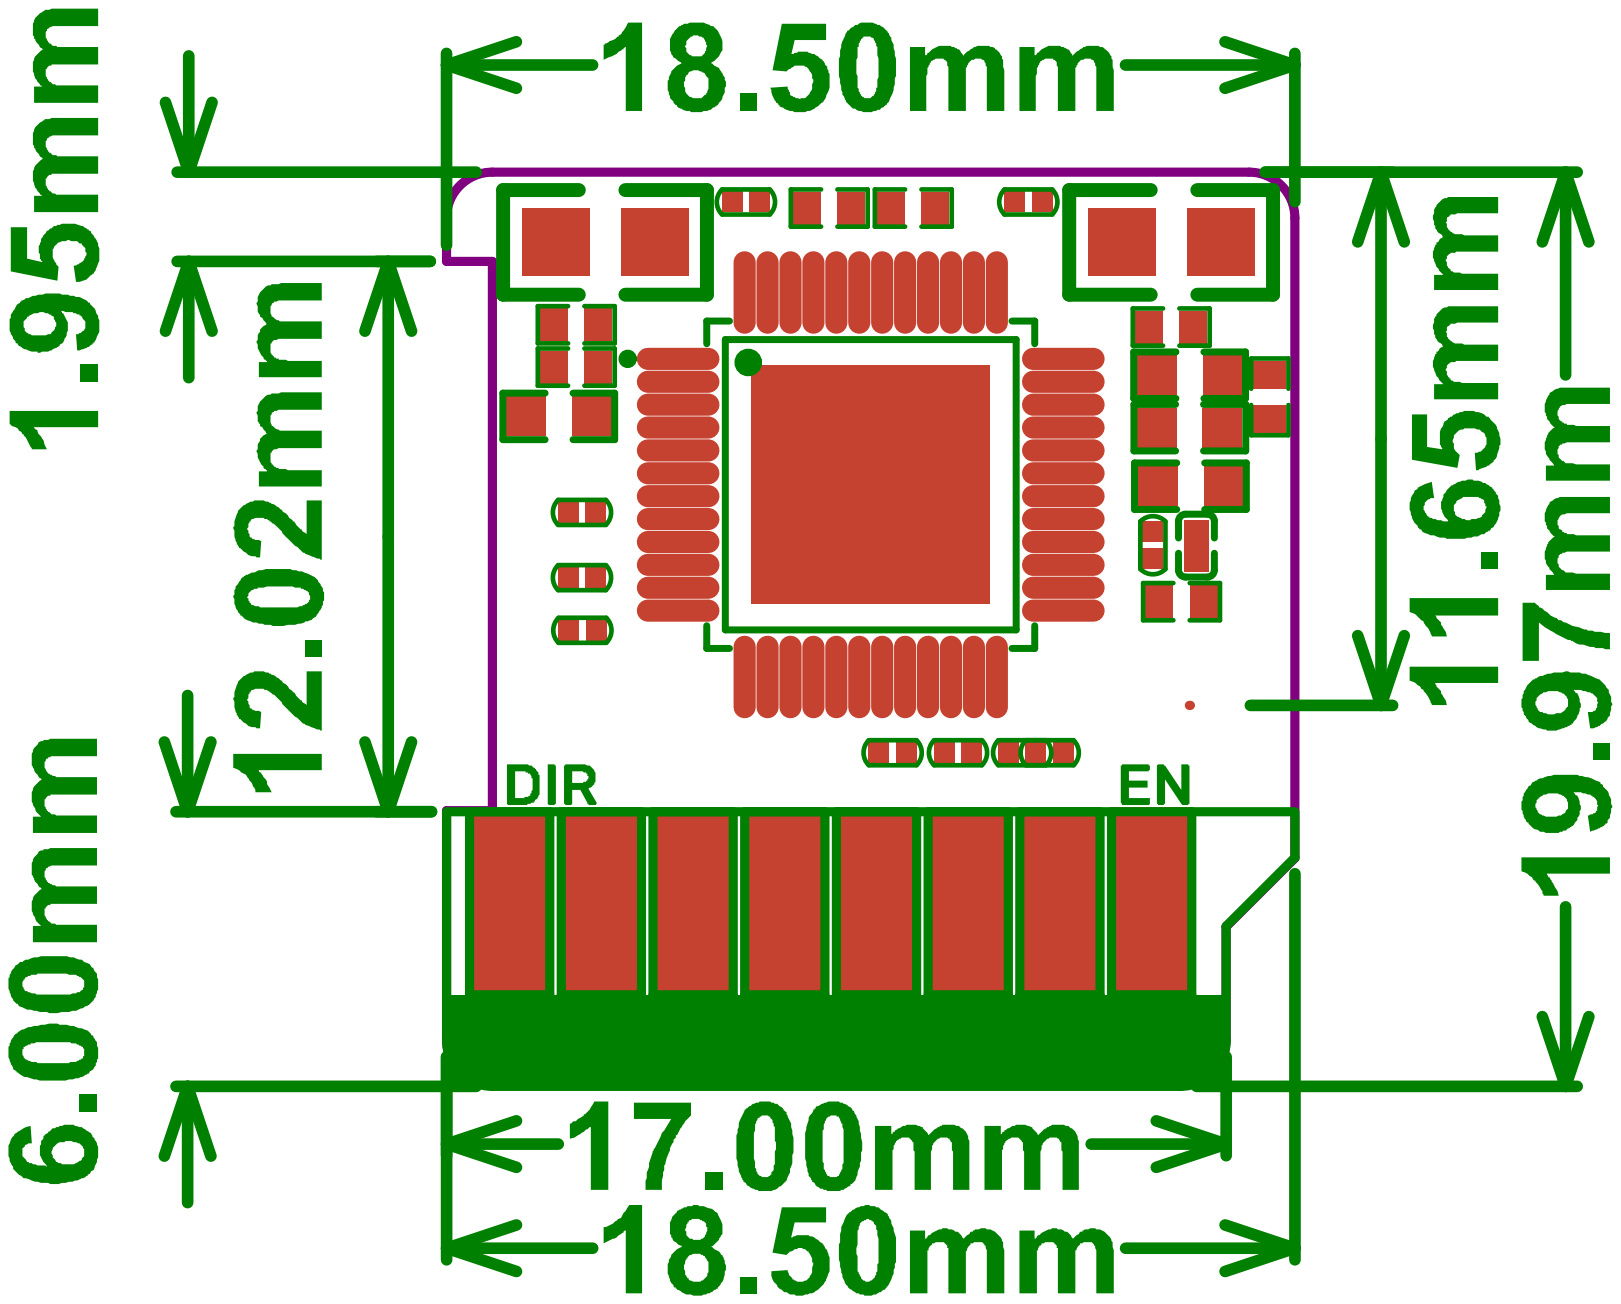
[picture p46: page 1]
