bigtreetech/BIGTREETECH-EZ-Driver/BIGTREETECH EZDriver Connector/BTT EZ-Driver Connector V1.0-bot.pdf

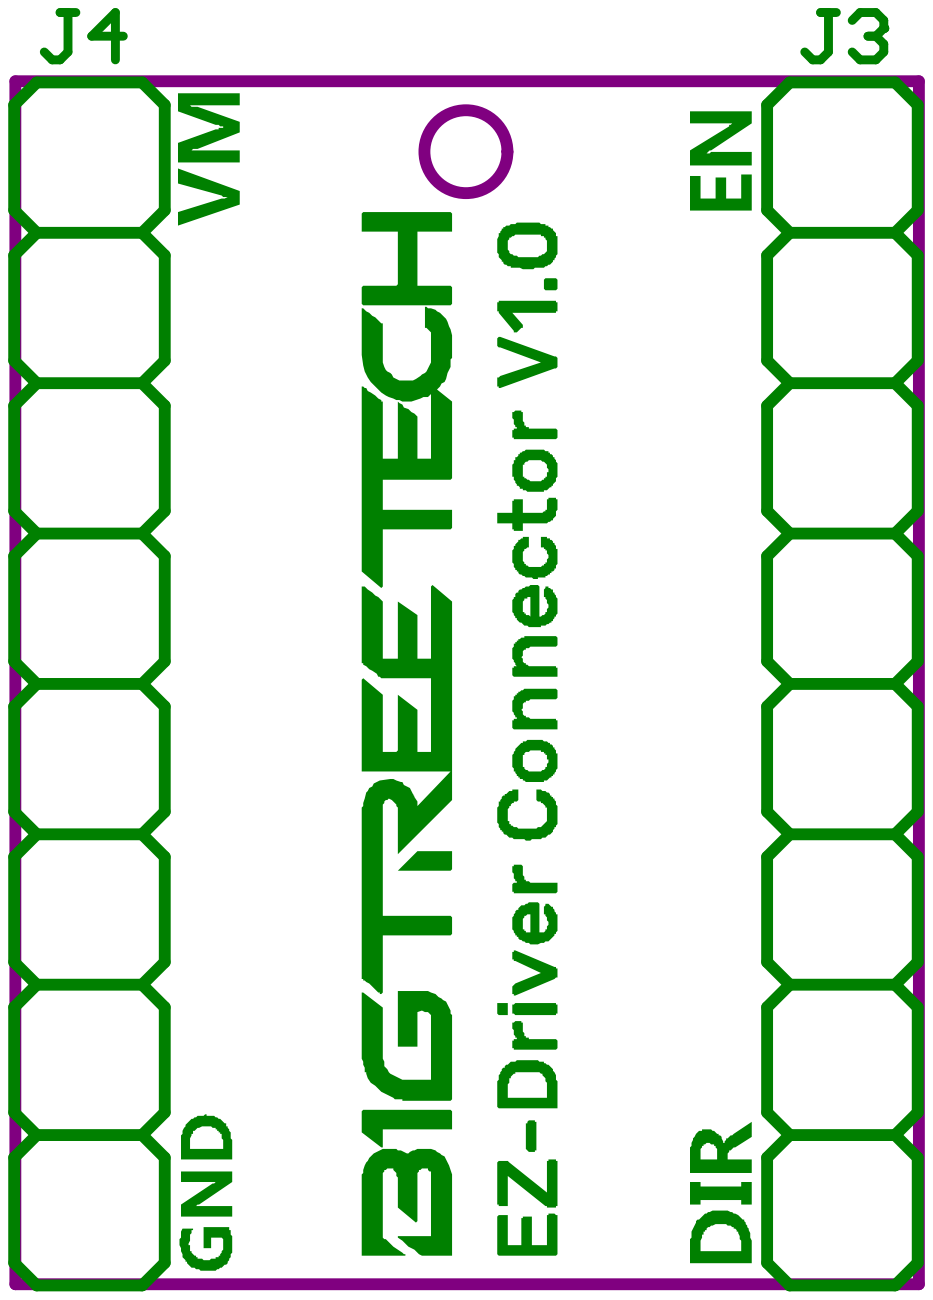
[picture p48: page 1]
