bigtreetech/BIGTREETECH-EZ-Driver/BIGTREETECH EZDriver Connector/BTT EZ-Driver Connector V1.0-top.pdf

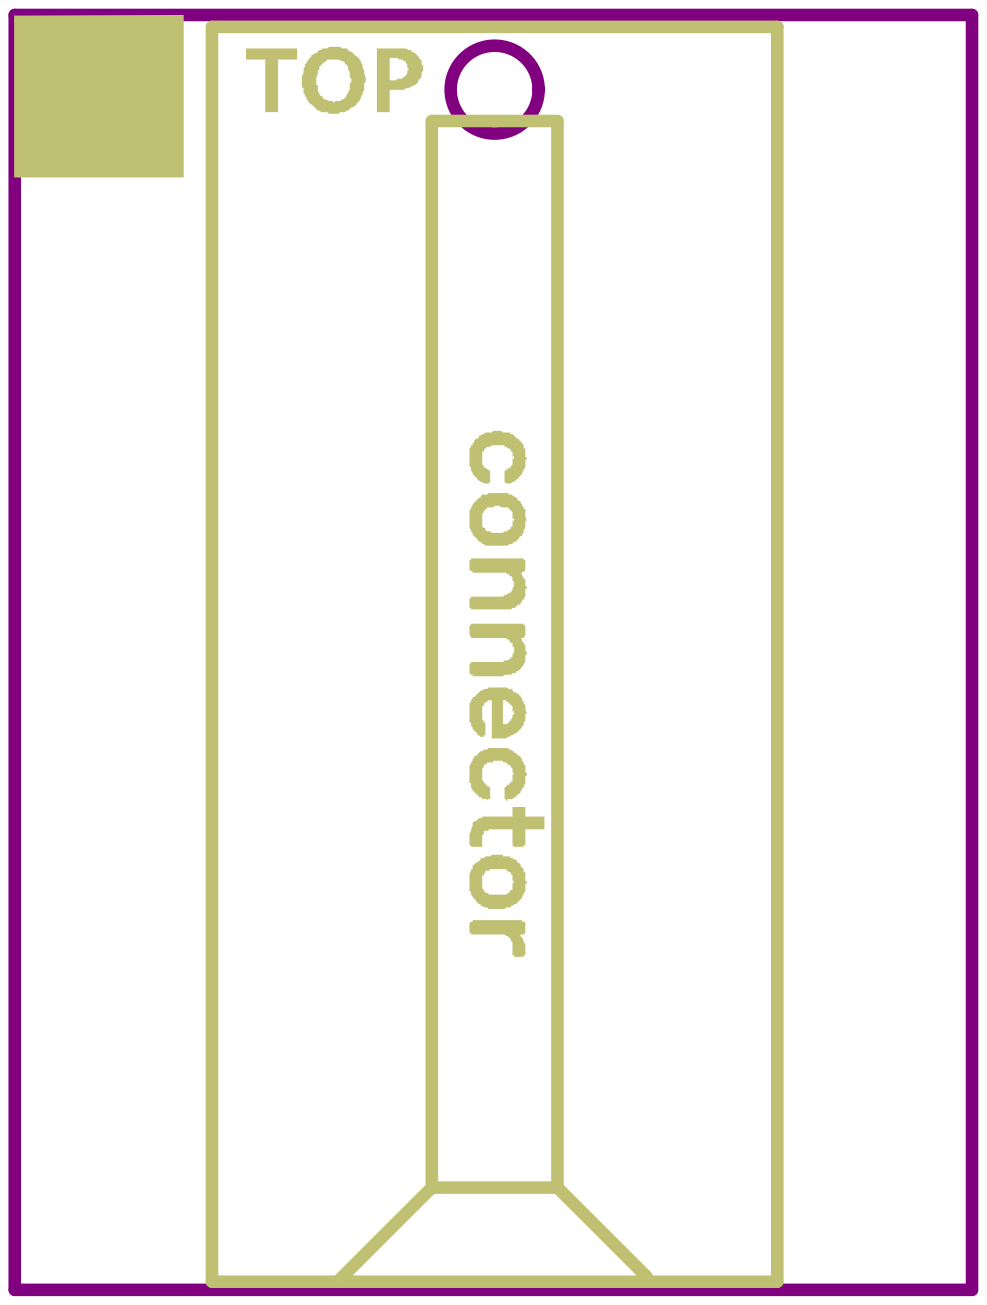
[picture p49: page 1]
