bigtreetech/BIGTREETECH-EZ-Driver/BIGTREETECH EZZ2209 V1.0/BIGTREETECH EZ2209 V1.0-bot.pdf

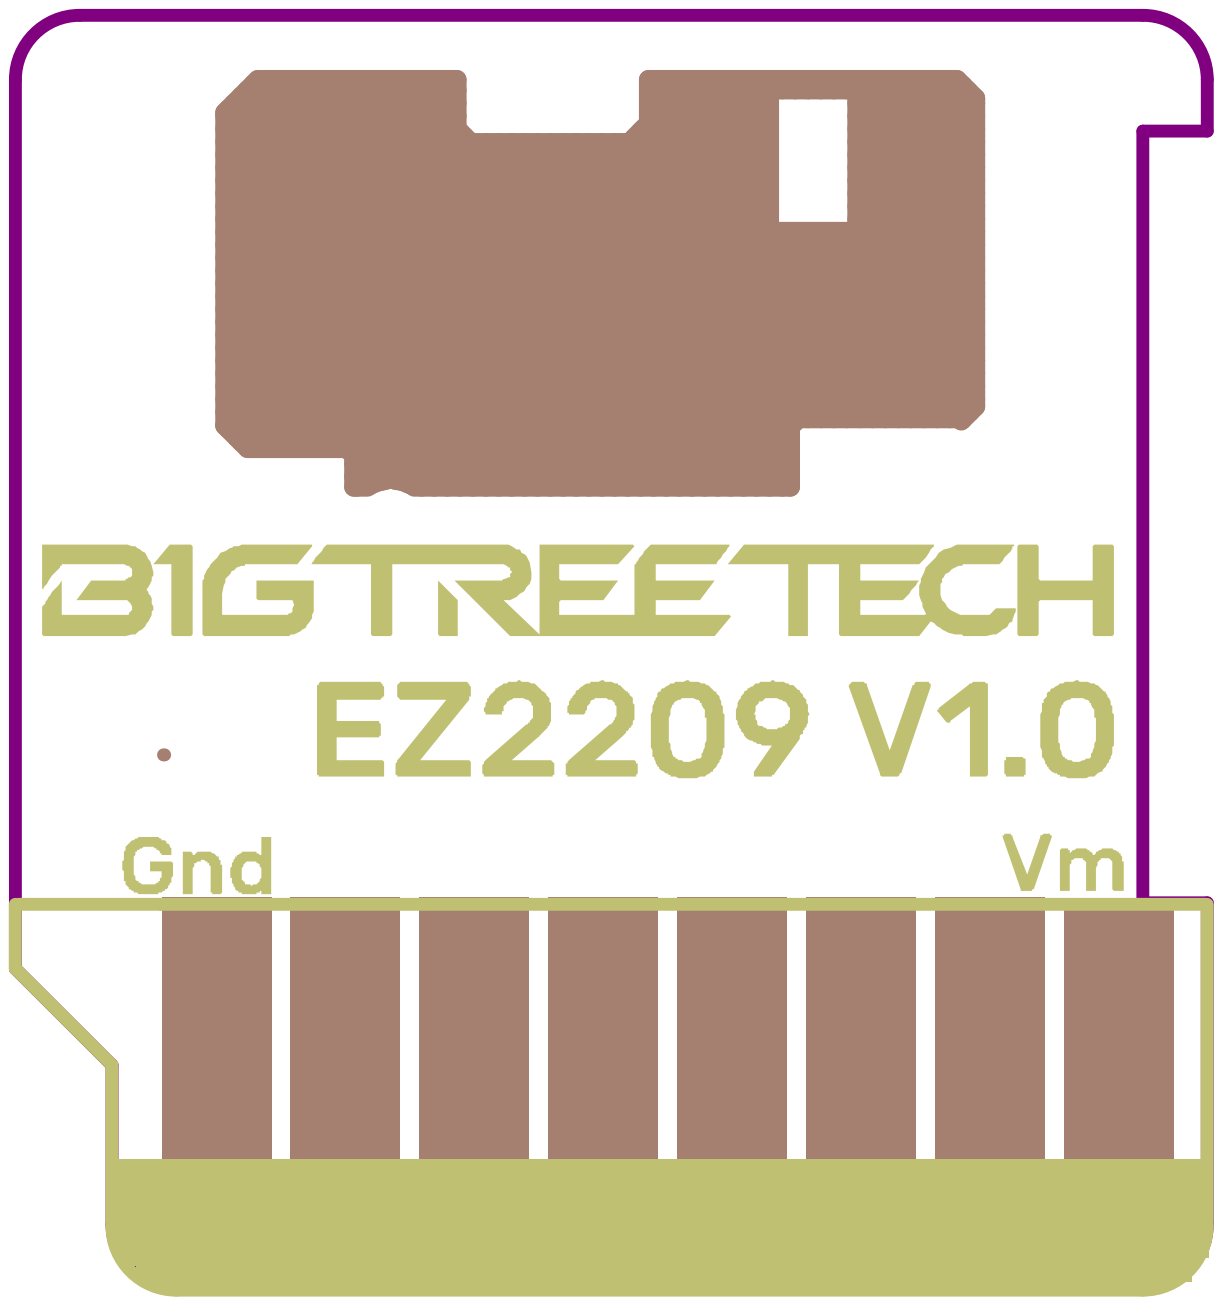
[picture p50: page 1]
