bigtreetech/BIGTREETECH-EZ-Driver/BIGTREETECH EZZ2209 V1.0/BIGTREETECH EZ2209 V1.0-SCH.pdf

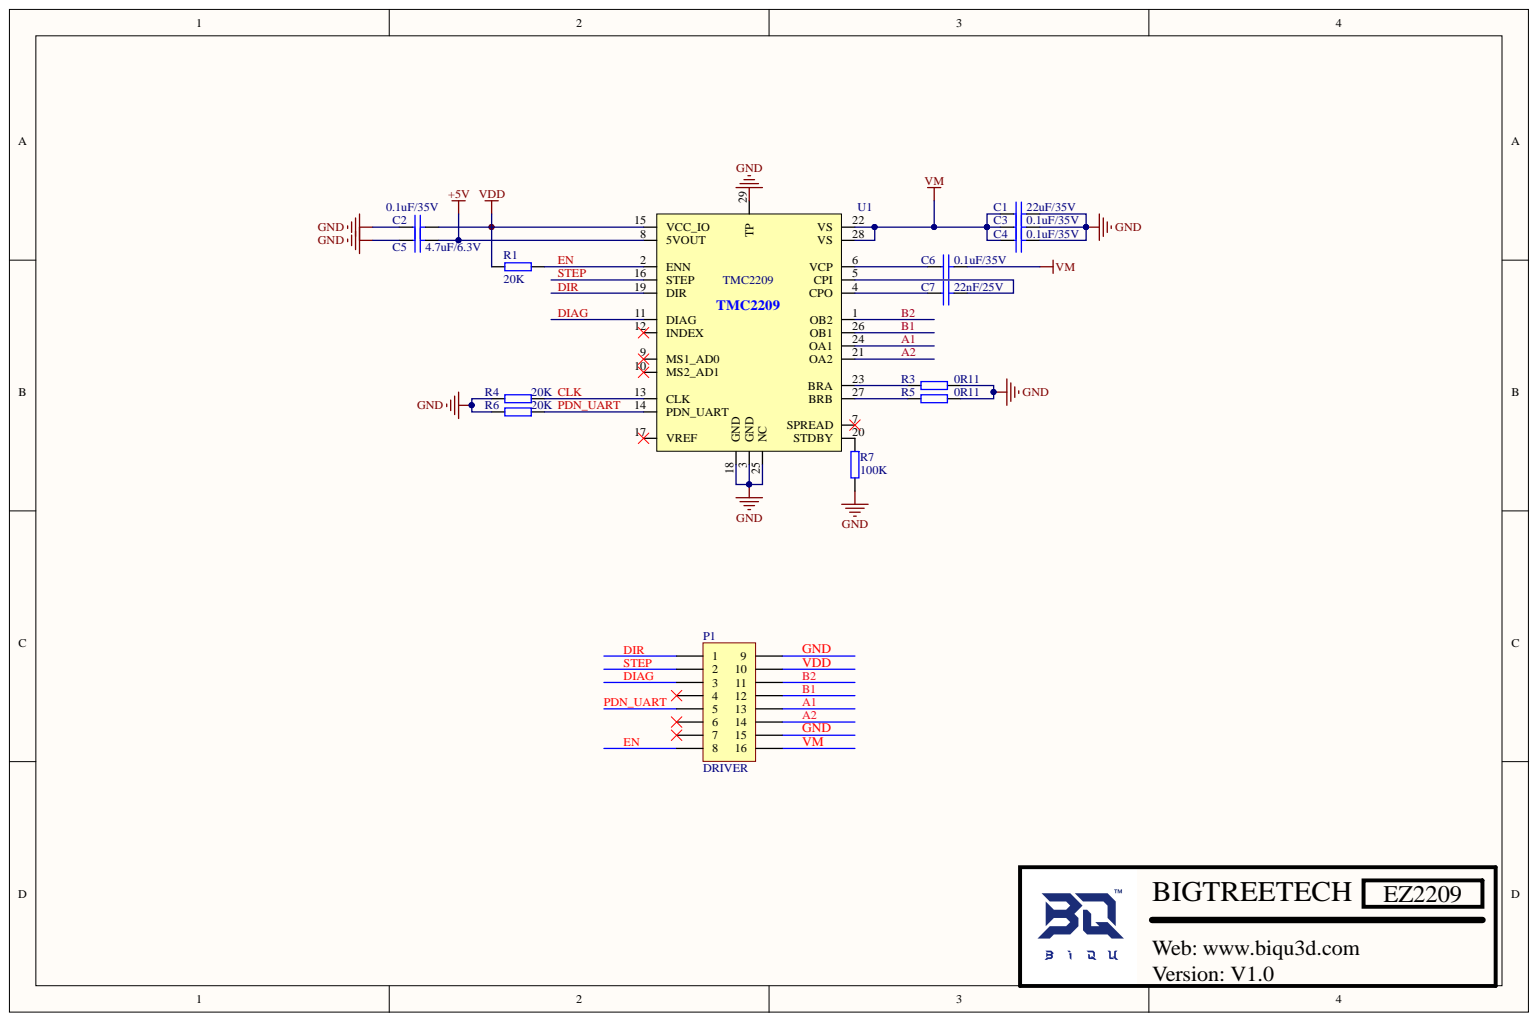
[picture p51: page 1]
