bigtreetech/BIGTREETECH-EZ-Driver/BIGTREETECH EZZ2209 V1.0/BIGTREETECH EZ2209 V1.0-top.pdf

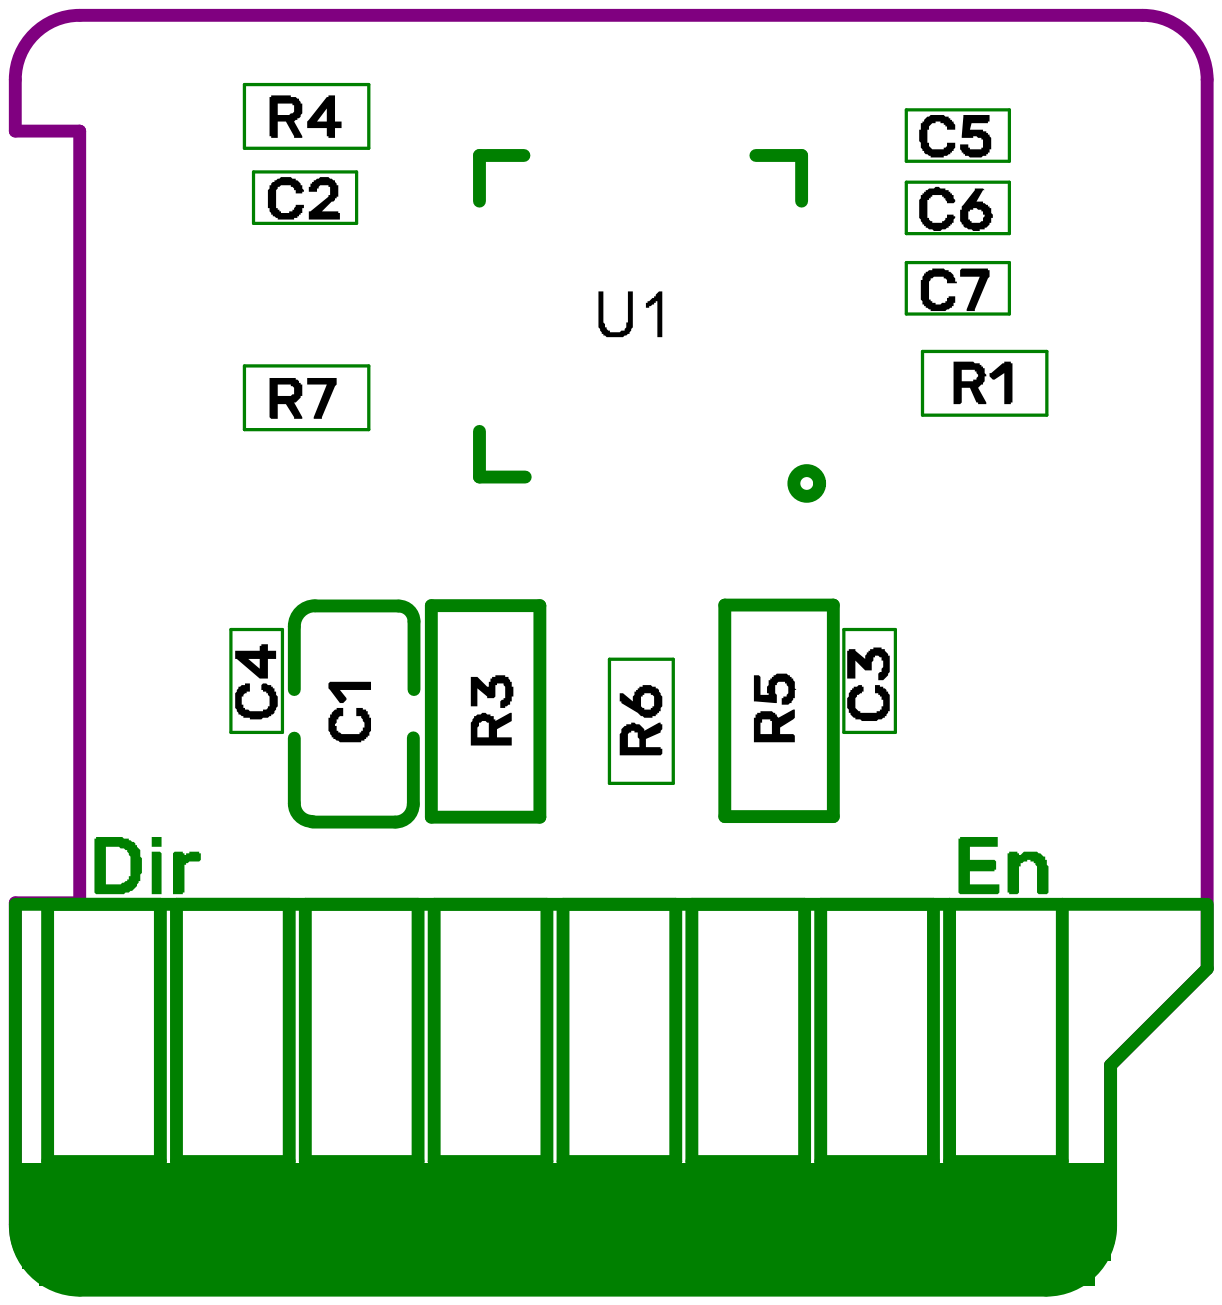
[picture p52: page 1]
