bigtreetech/BIGTREETECH-EZ-Driver/BIGTREETECH EZ2208 V1.0/BIGTREETECH EZ2208 V1.0-bot.pdf

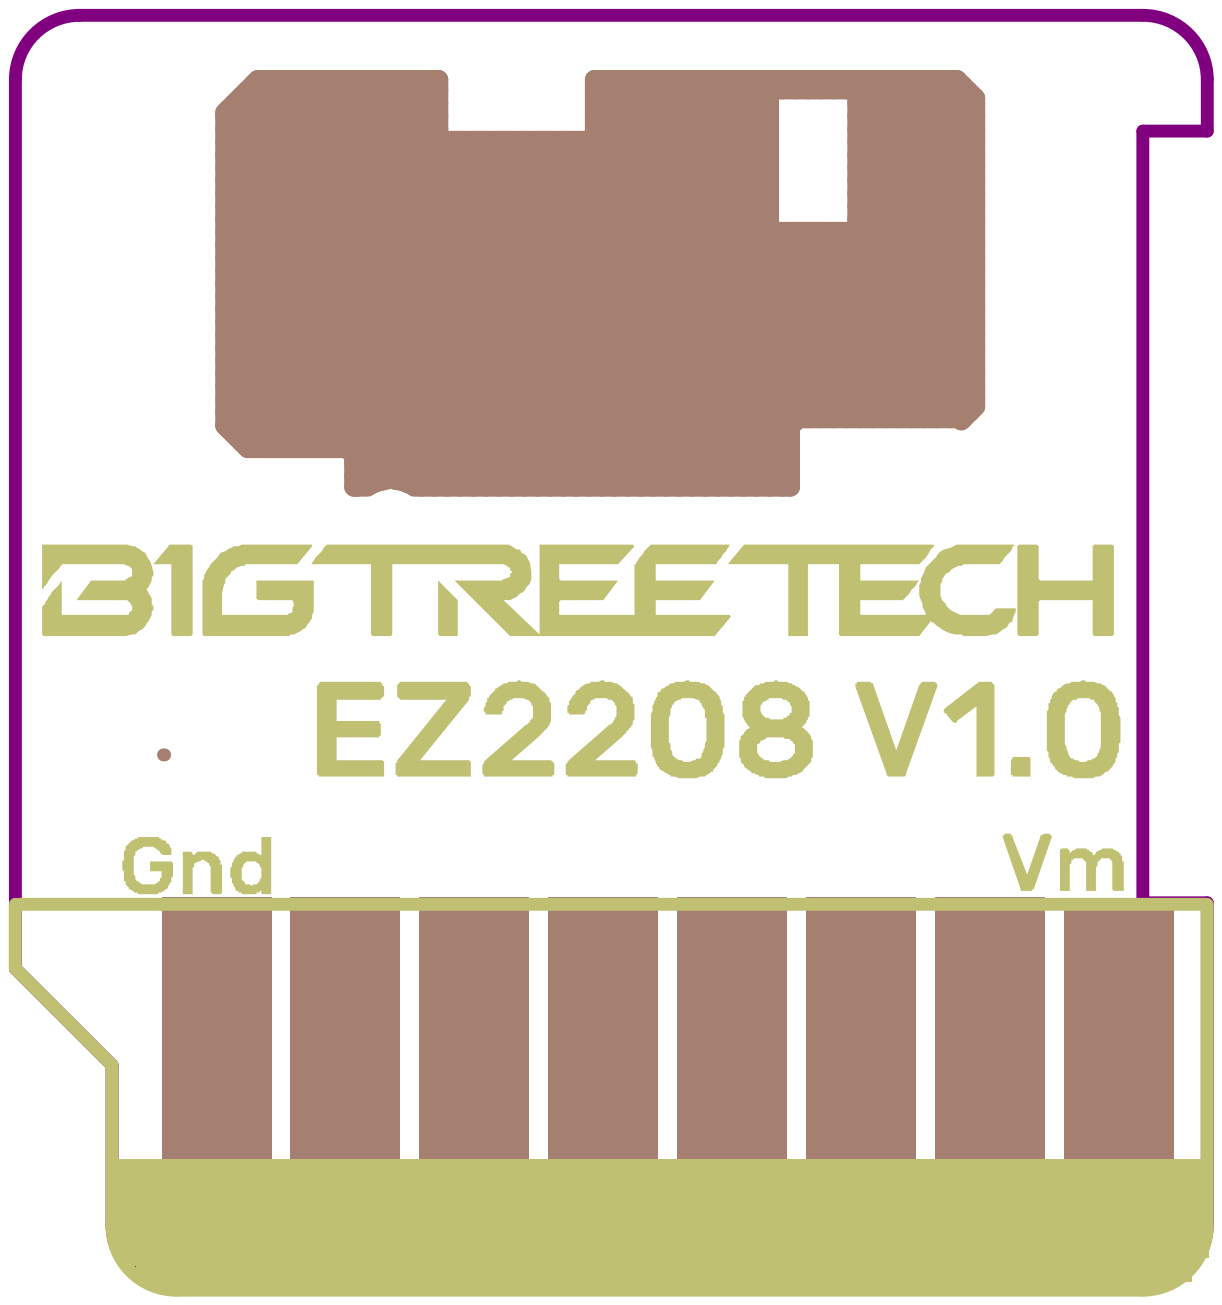
[picture p53: page 1]
