bigtreetech/BIGTREETECH-EZ-Driver/BIGTREETECH EZ2208 V1.0/BIGTREETECH EZ2208 V1.0-SCH.pdf

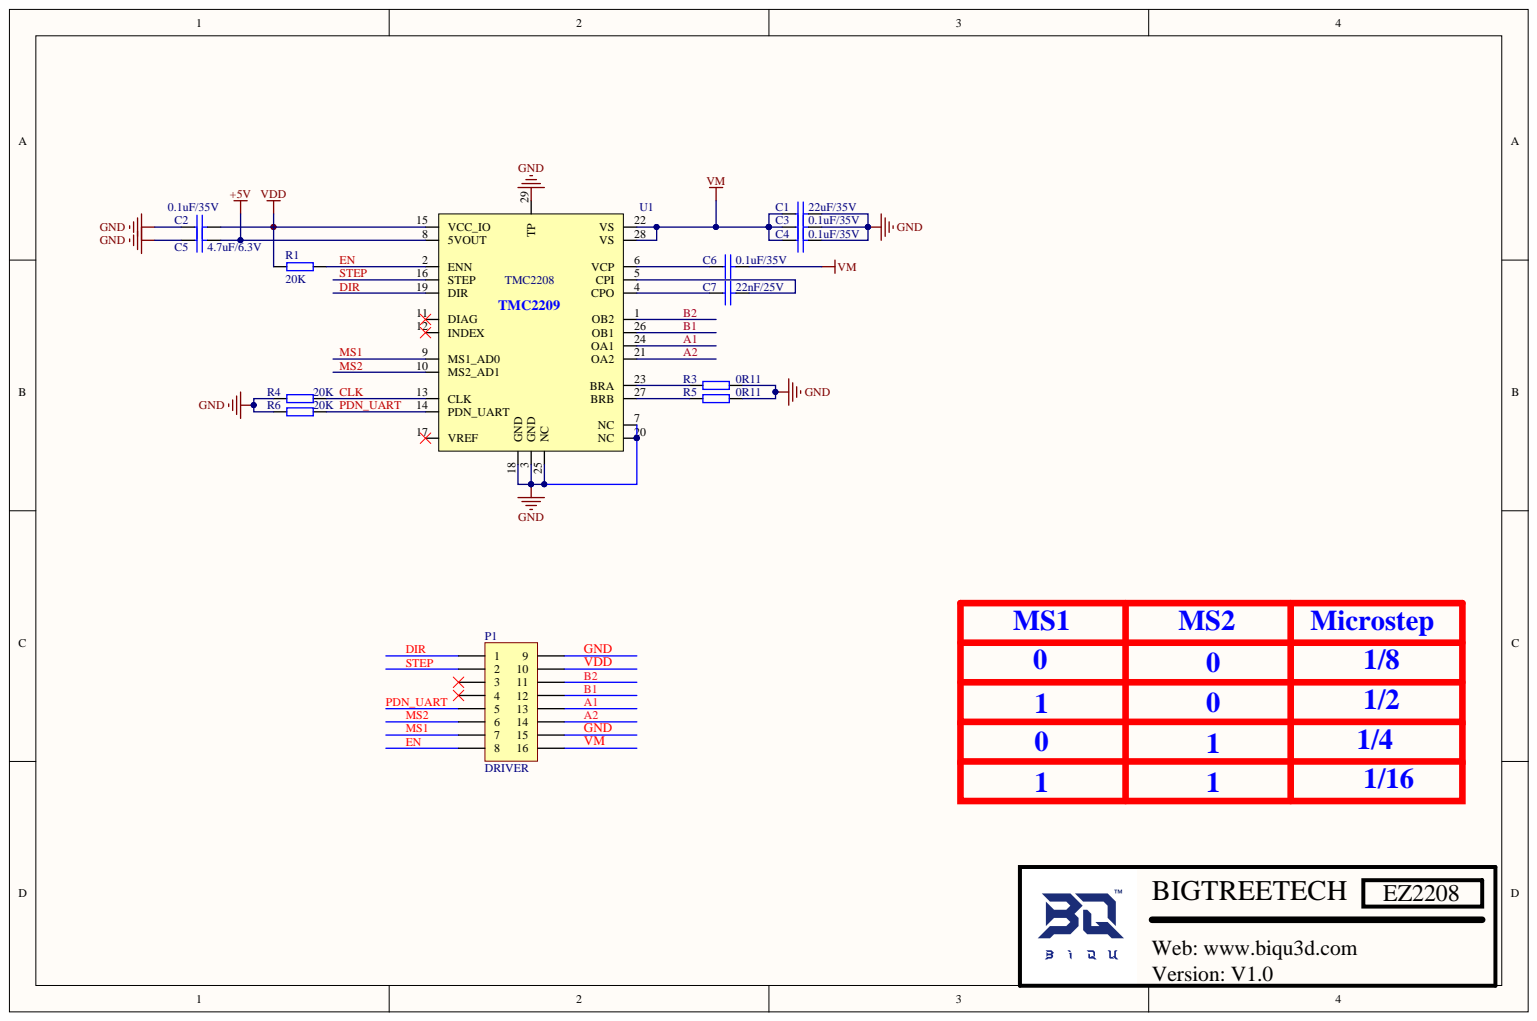
[picture p54: page 1]
