bigtreetech/BIGTREETECH-EZ-Driver/BIGTREETECH EZ2208 V1.0/BIGTREETECH EZ2208 V1.0-top.pdf

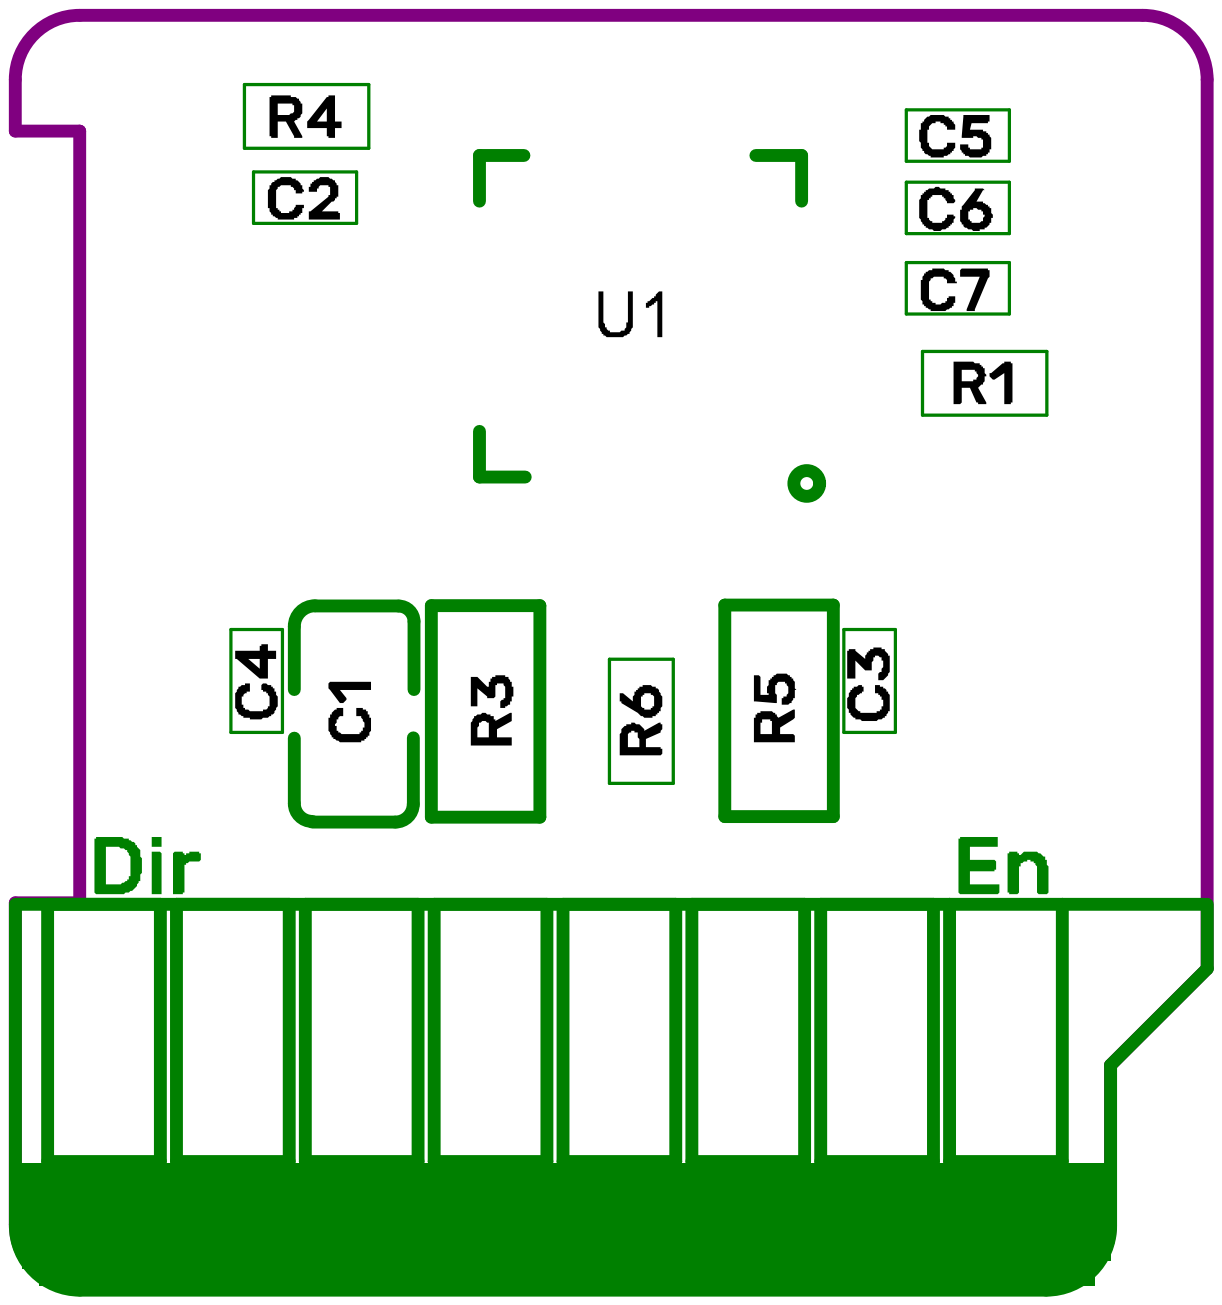
[picture p55: page 1]
