bigtreetech/BIGTREETECH-EZ-Driver/BIGTREETECH EZ5160RGB/Hardware/BIGTREETECH EZ5160 RGB V1.0-SCH.pdf

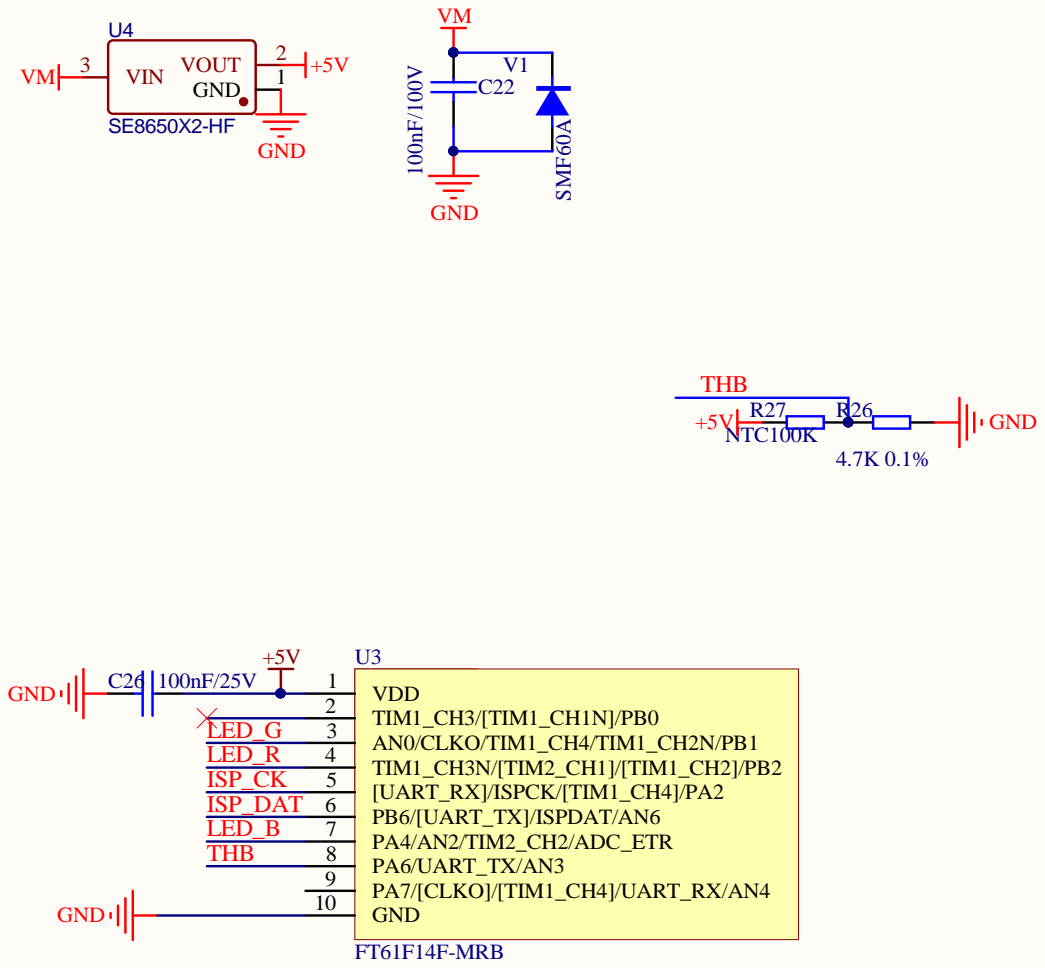
[picture p33: page 1]

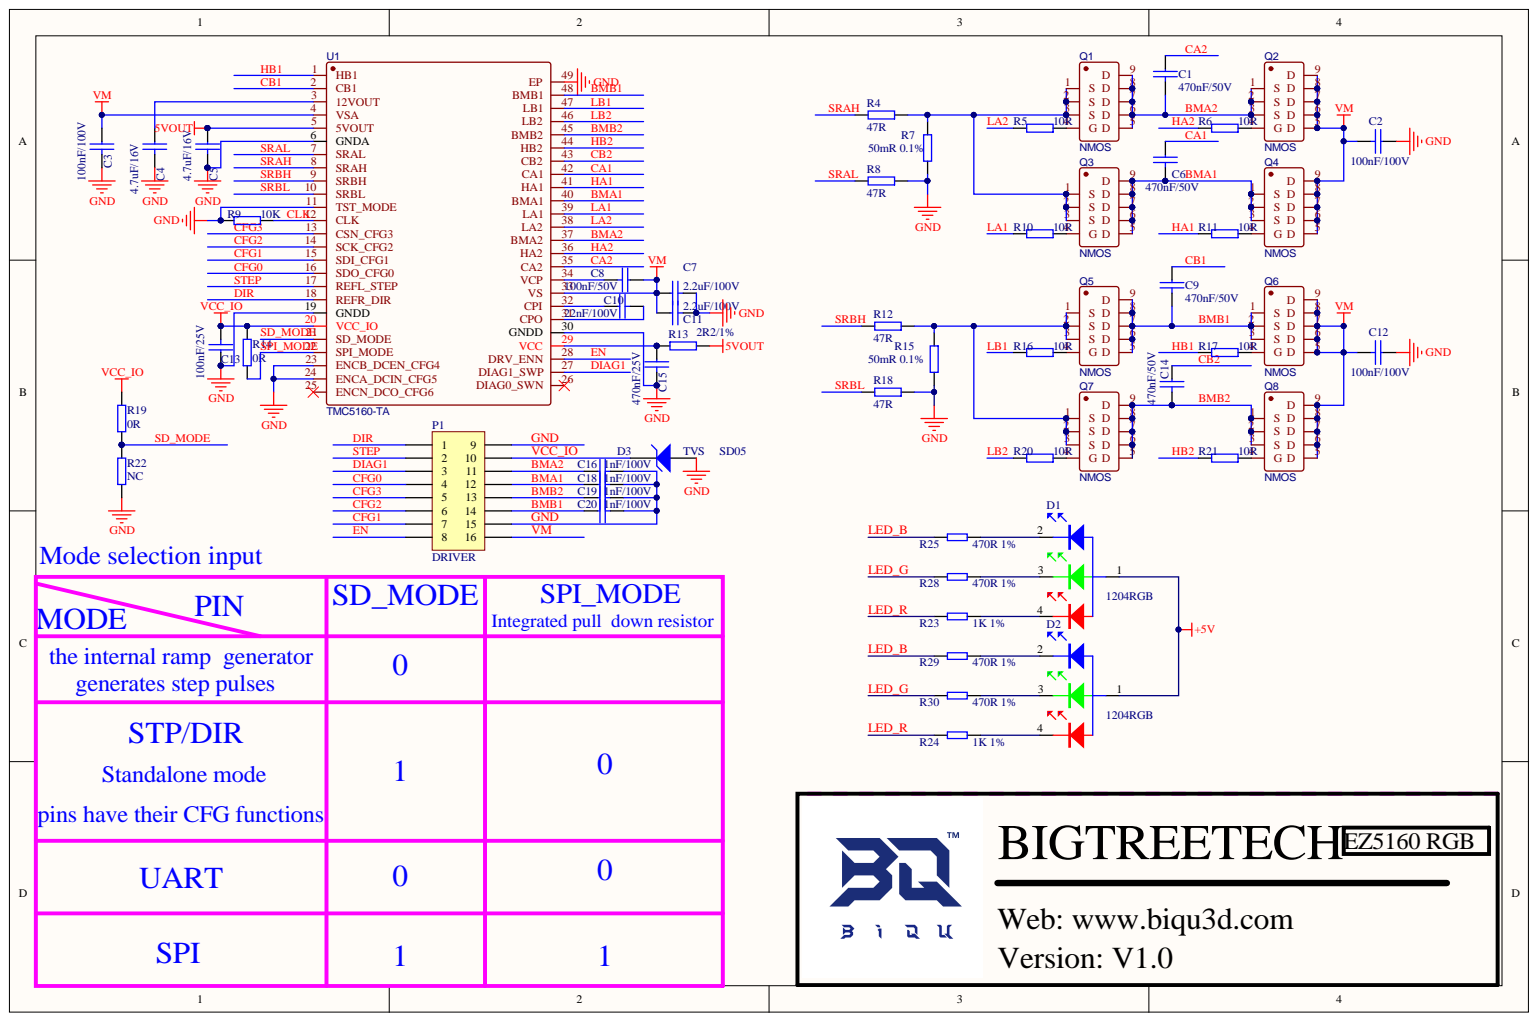
[picture p34: page 2]

M PIN ODE | SD_MODE | SPI_MODE Integrated pull down resistor

generates step pulses | 0 the internal ramp generator

STP/DIR Standalone mode pins have their CFG functions | 1 | 0

UART | 0 | 0

SPI | 1 | 1
