bigtreetech/BIGTREETECH-EZ-Driver/BIGTREETECH EZ5160RGB/Hardware/BIGTREETECH EZ5160RGB V1.0-bot.pdf

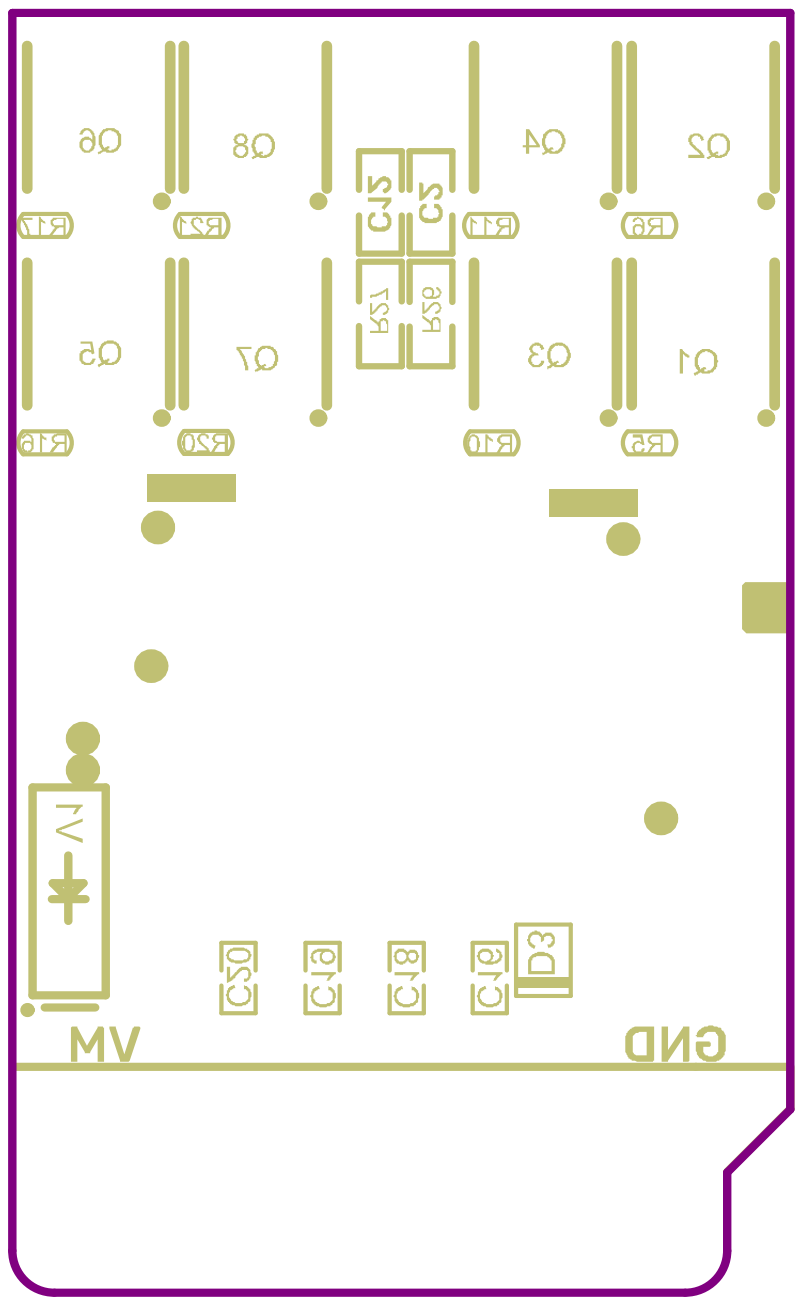
[picture p35: page 1]
