bigtreetech/BIGTREETECH-EZ-Driver/BIGTREETECH EZ5160RGB/Hardware/BIGTREETECH EZ5160RGB V1.0-top.pdf

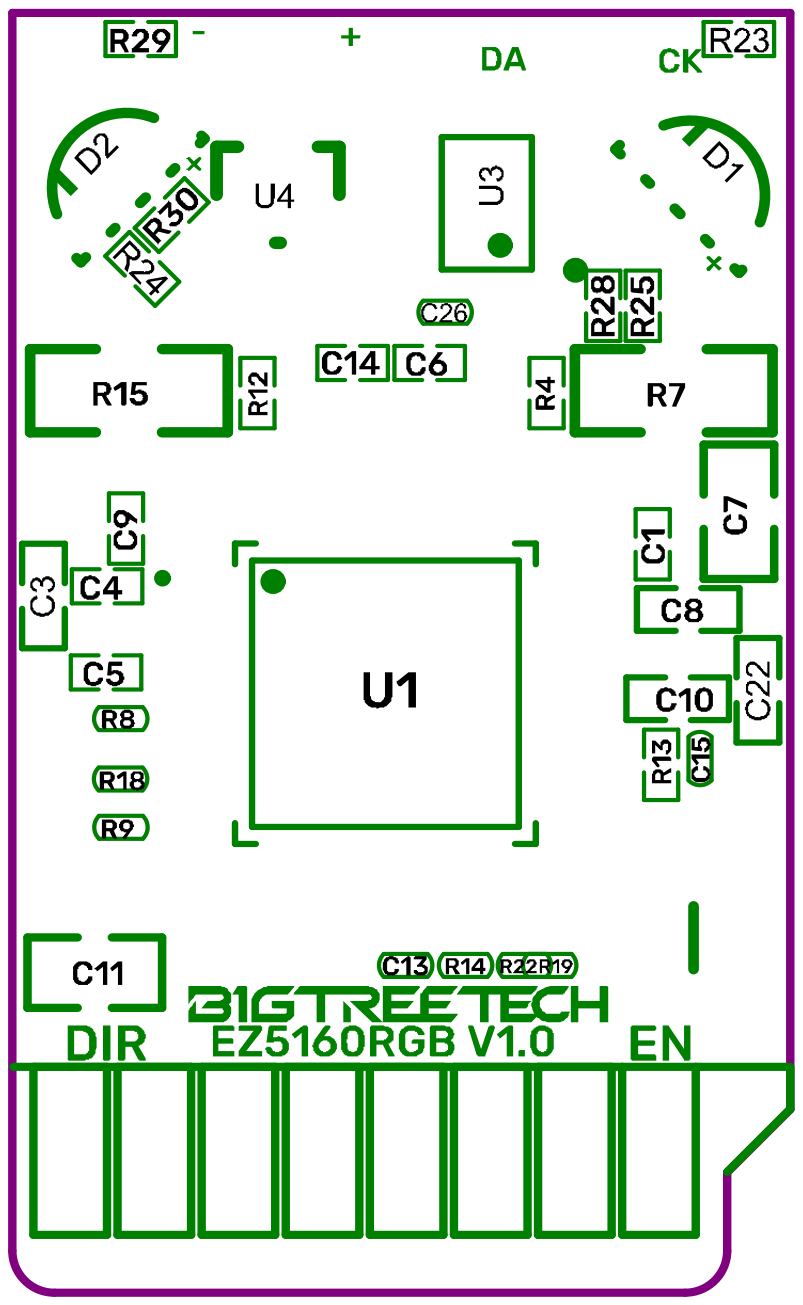
[picture p36: page 1]
