bigtreetech/BIGTREETECH-EZ-Driver/BIGTREETECH EZ2226 V1.0/Hardware/BIGTREETECH EZ2226 V1.0-SCH.pdf

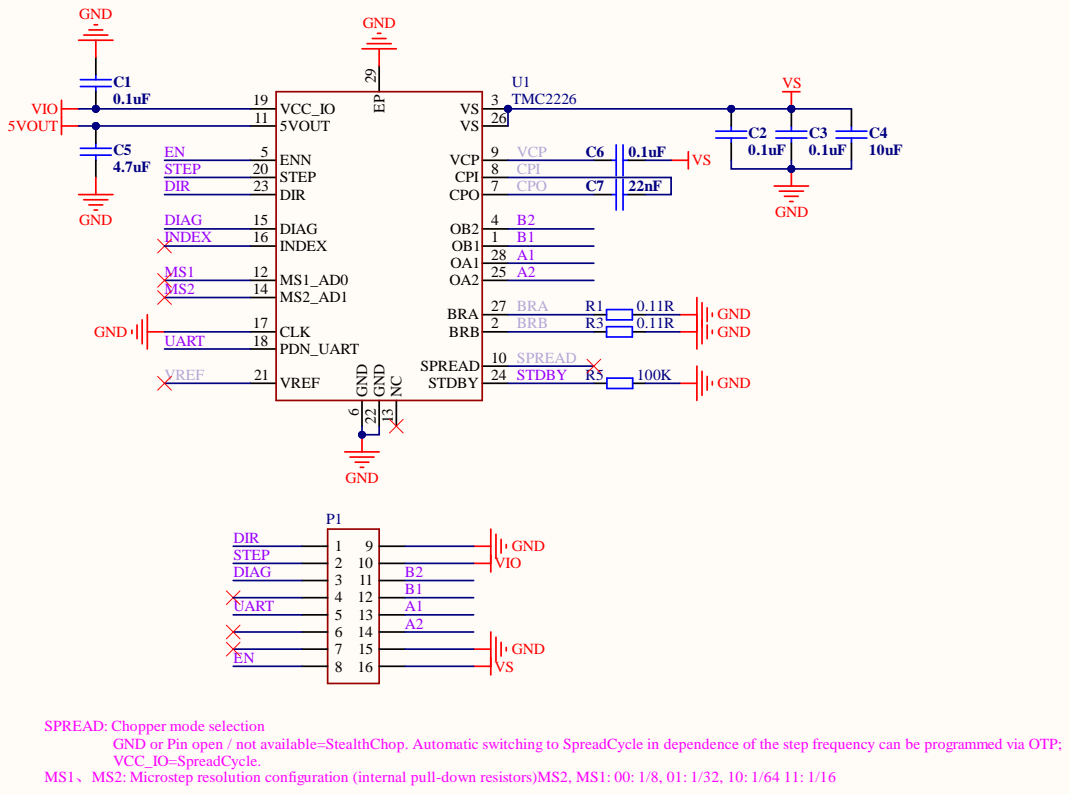
[picture p37: page 1]

uency can be pro
