bigtreetech/BIGTREETECH-EZ-Driver/BIGTREETECH EZ2226 V1.0/Hardware/BIGTREETECH EZ2226 V1.0-SIZE.pdf

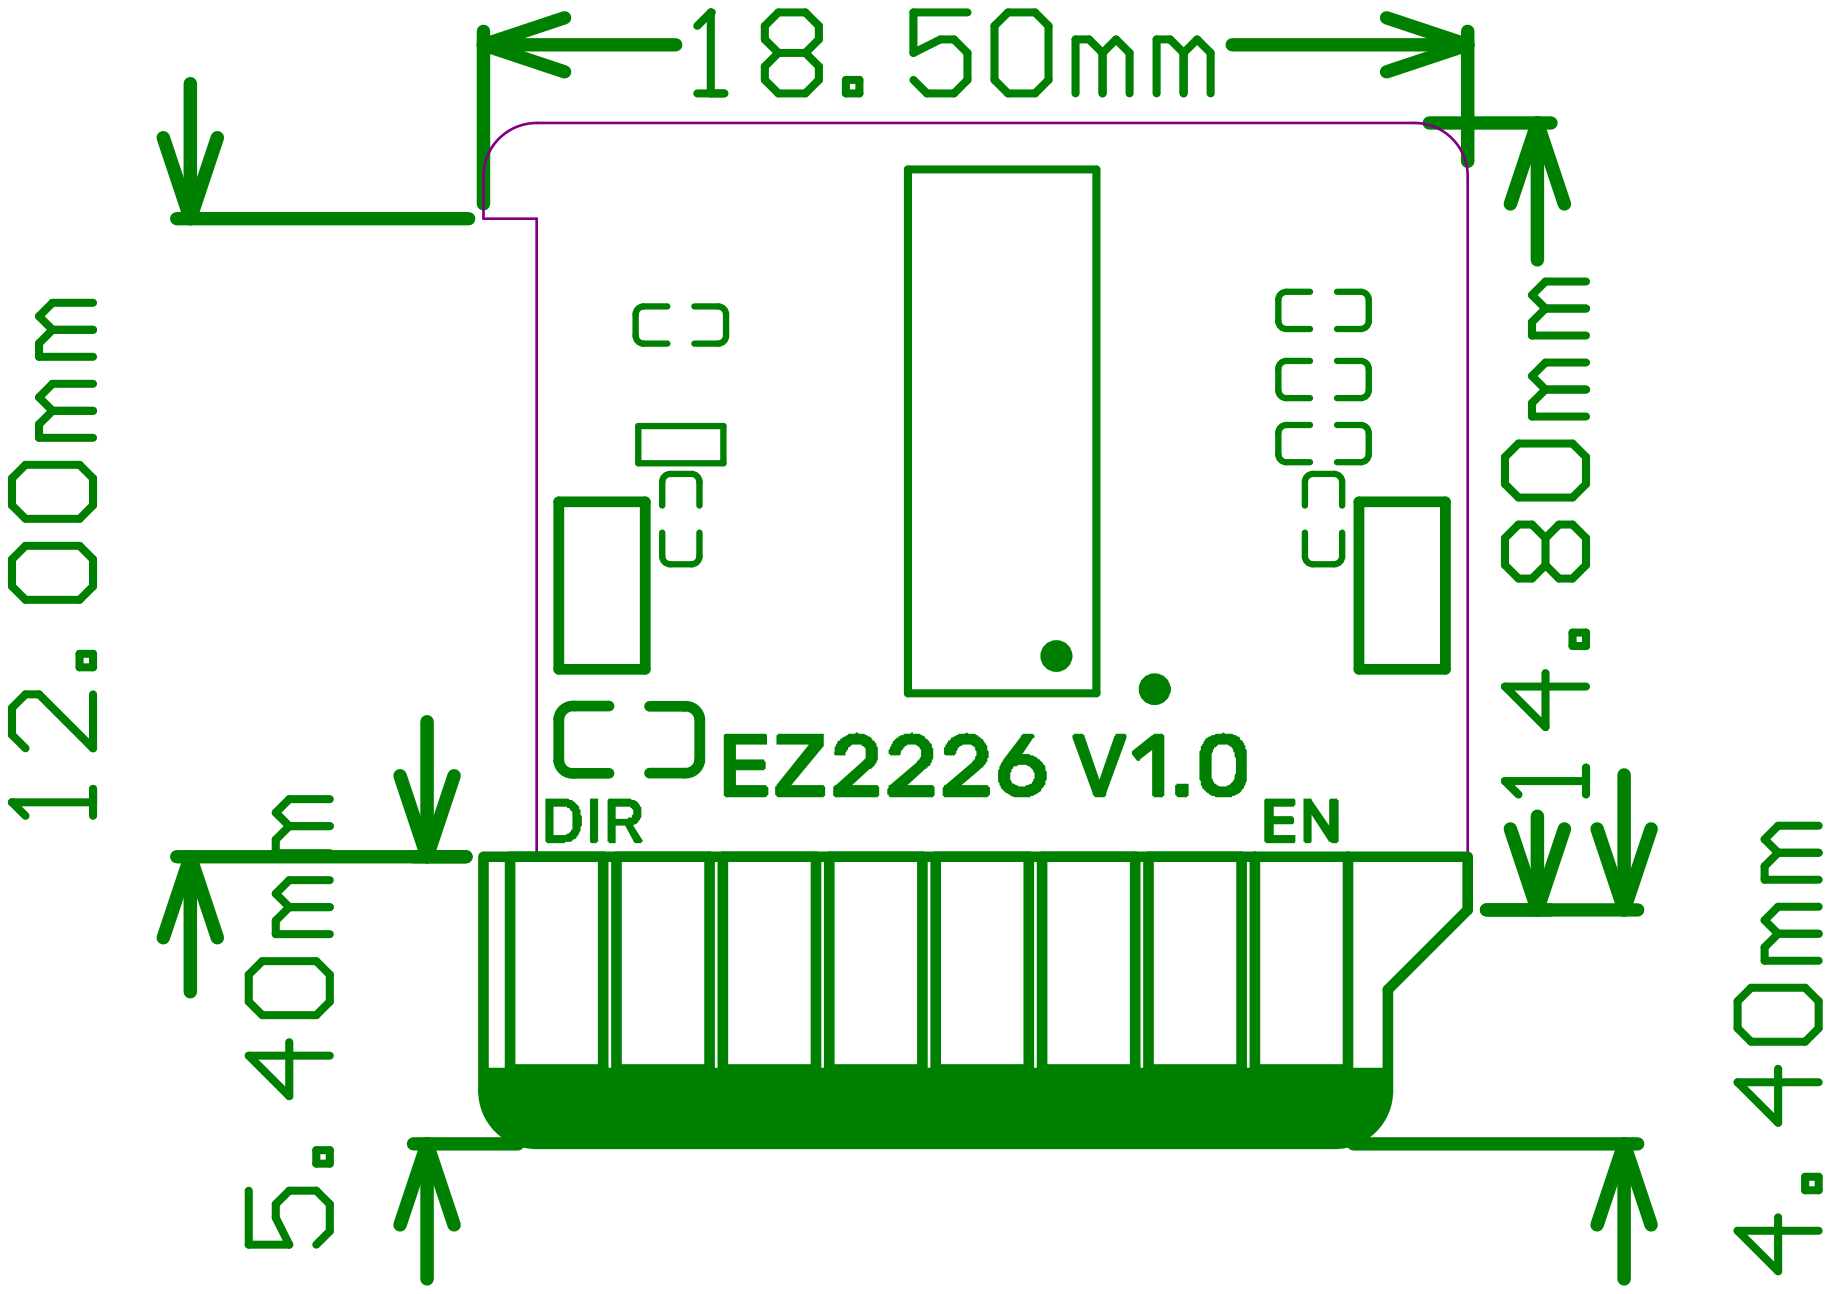
[picture p38: page 1]
