bigtreetech/BIGTREETECH-EZ-Driver/BIGTREETECH EZ6609 V1.0/Hardware/BIGTREETECH EZ6609 V1.0-SCH.pdf

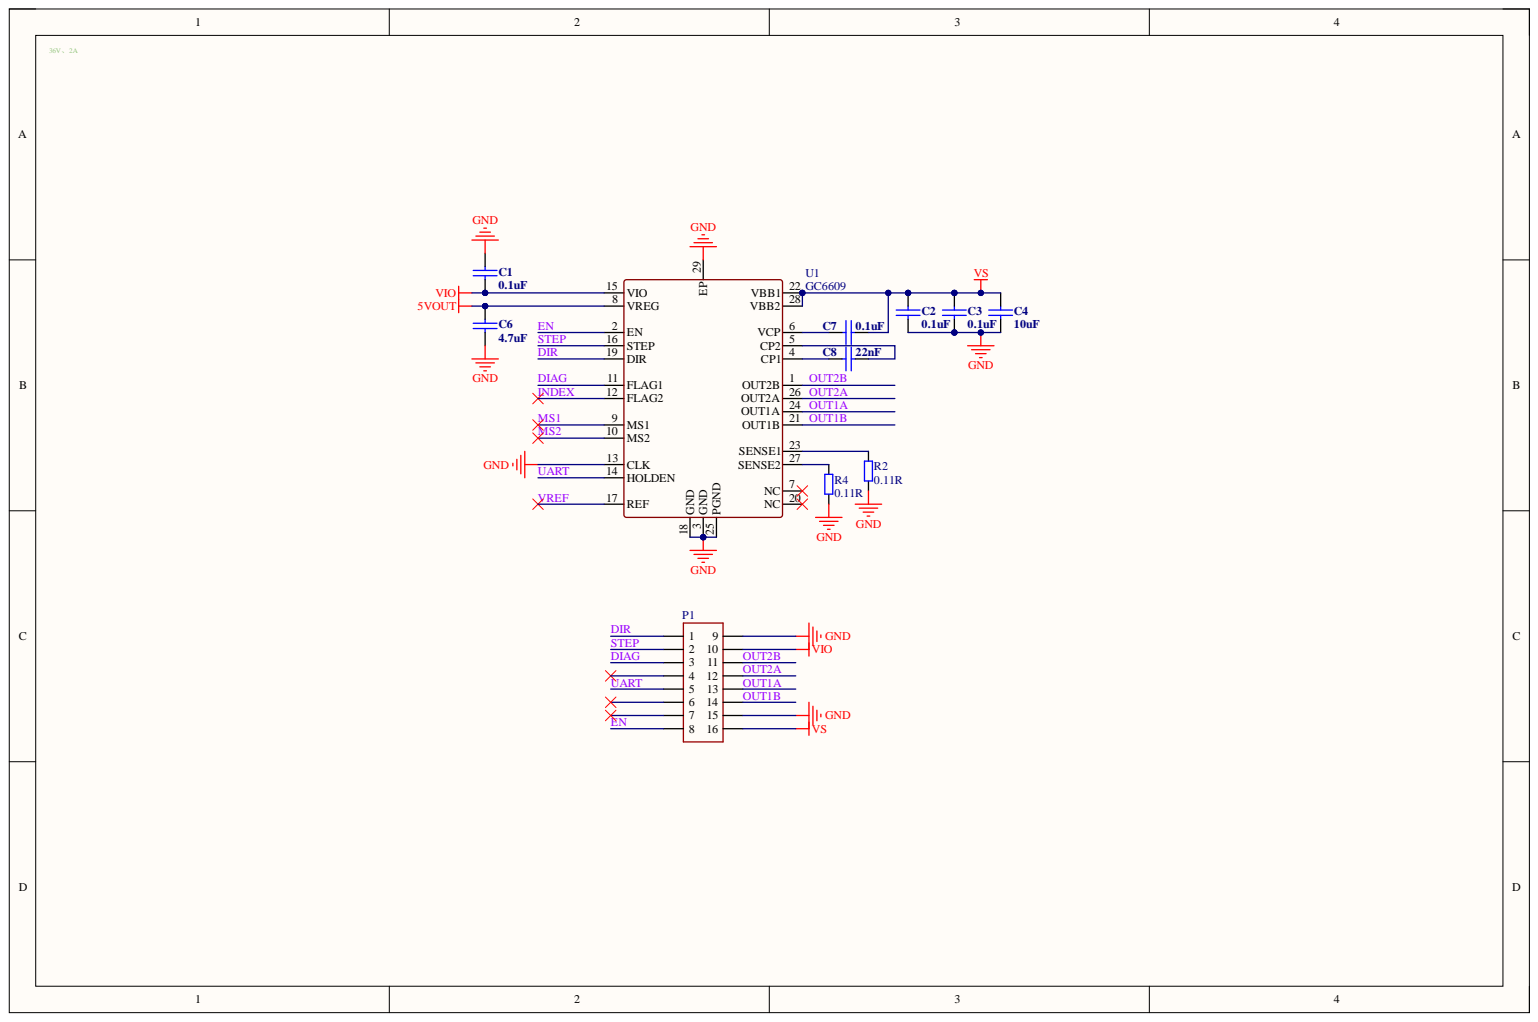
[picture p39: page 1]
