bigtreetech/BIGTREETECH-EZ-Driver/BIGTREETECH EZ6609 V1.0/Hardware/BIGTREETECH EZ6609 V1.0-SIZE.pdf

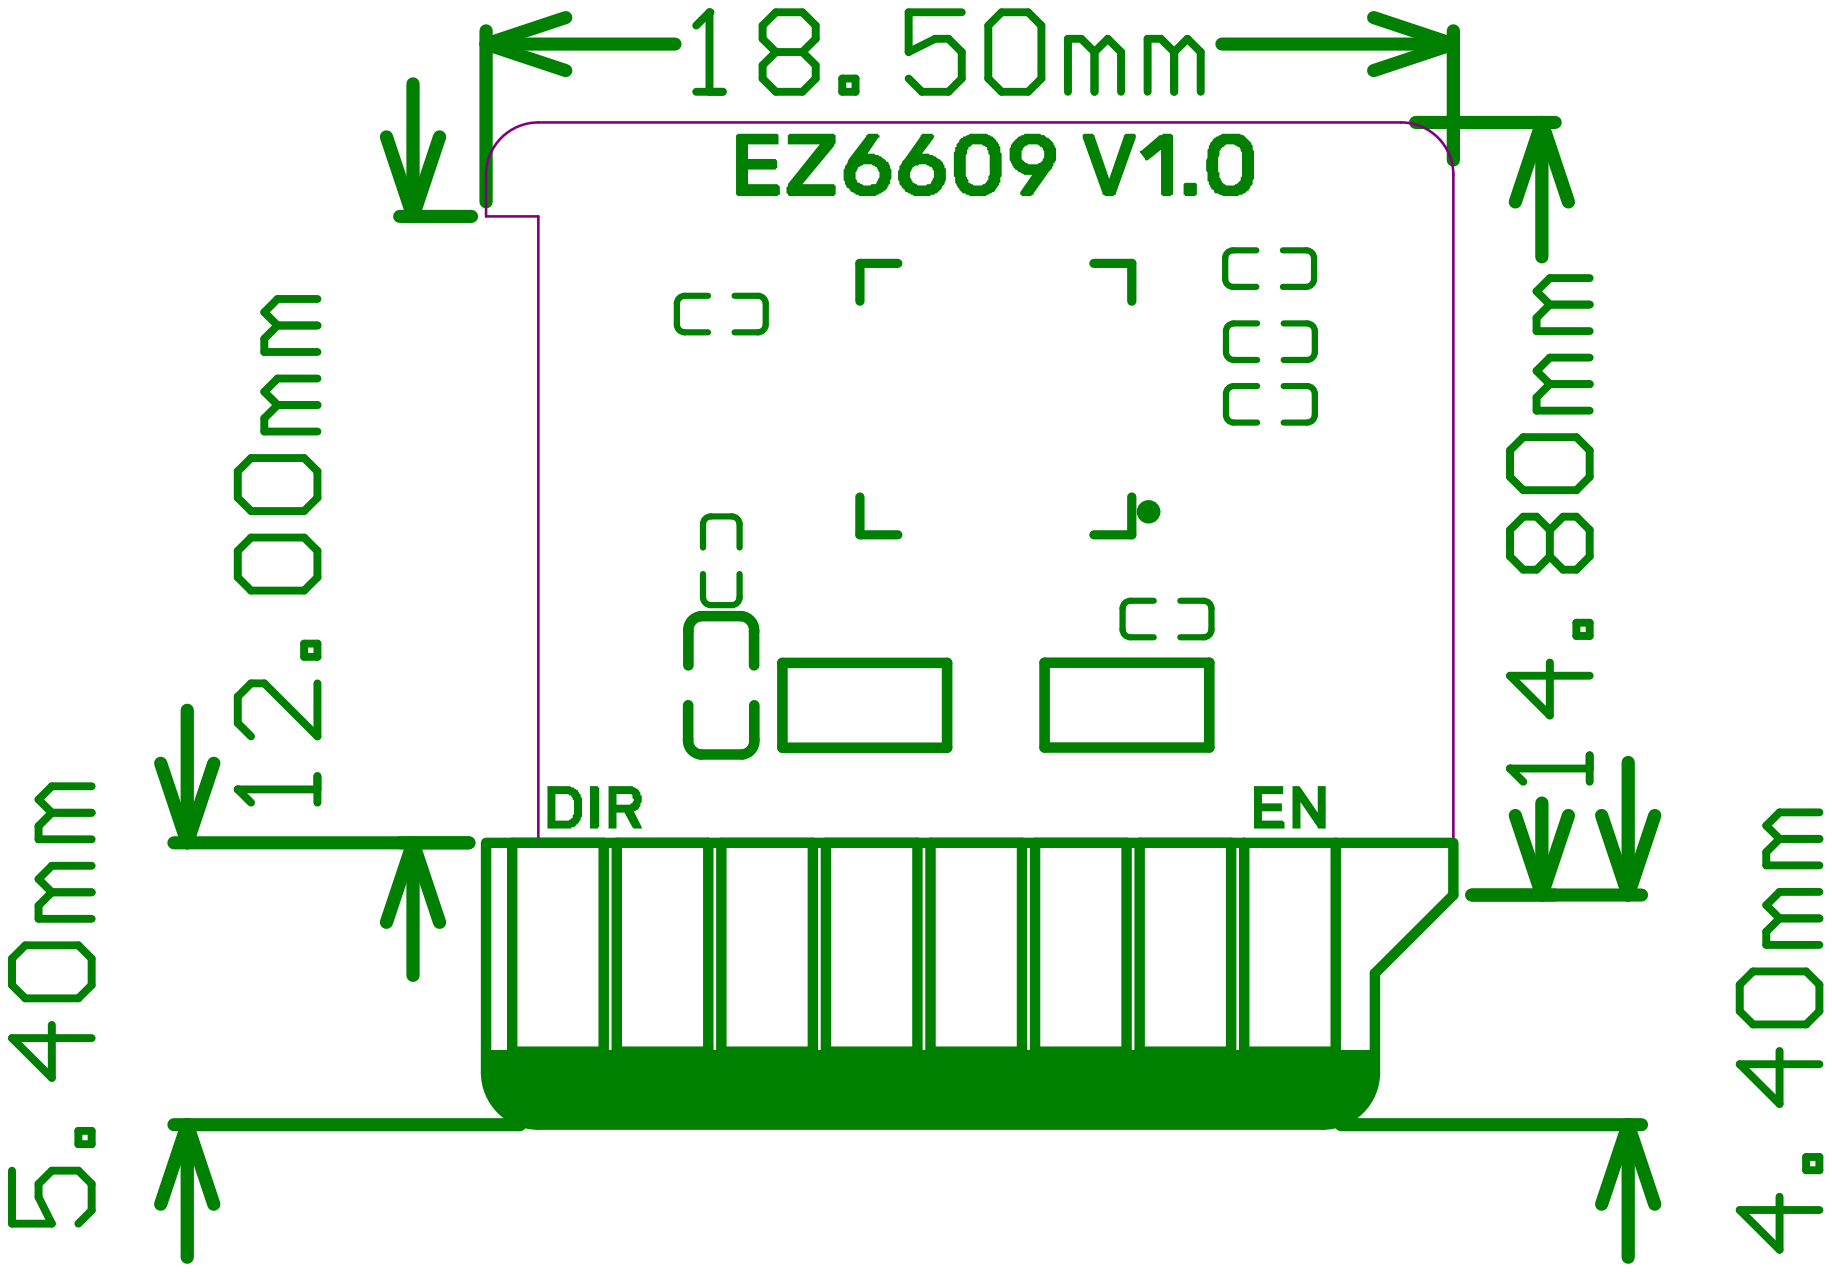
[picture p40: page 1]
