bigtreetech/BIGTREETECH-EZ-Driver/BIGTREETECH EZ2225 V1.0/Hardware/BIGTREETECH EZ2225 V1.0-SCH.pdf

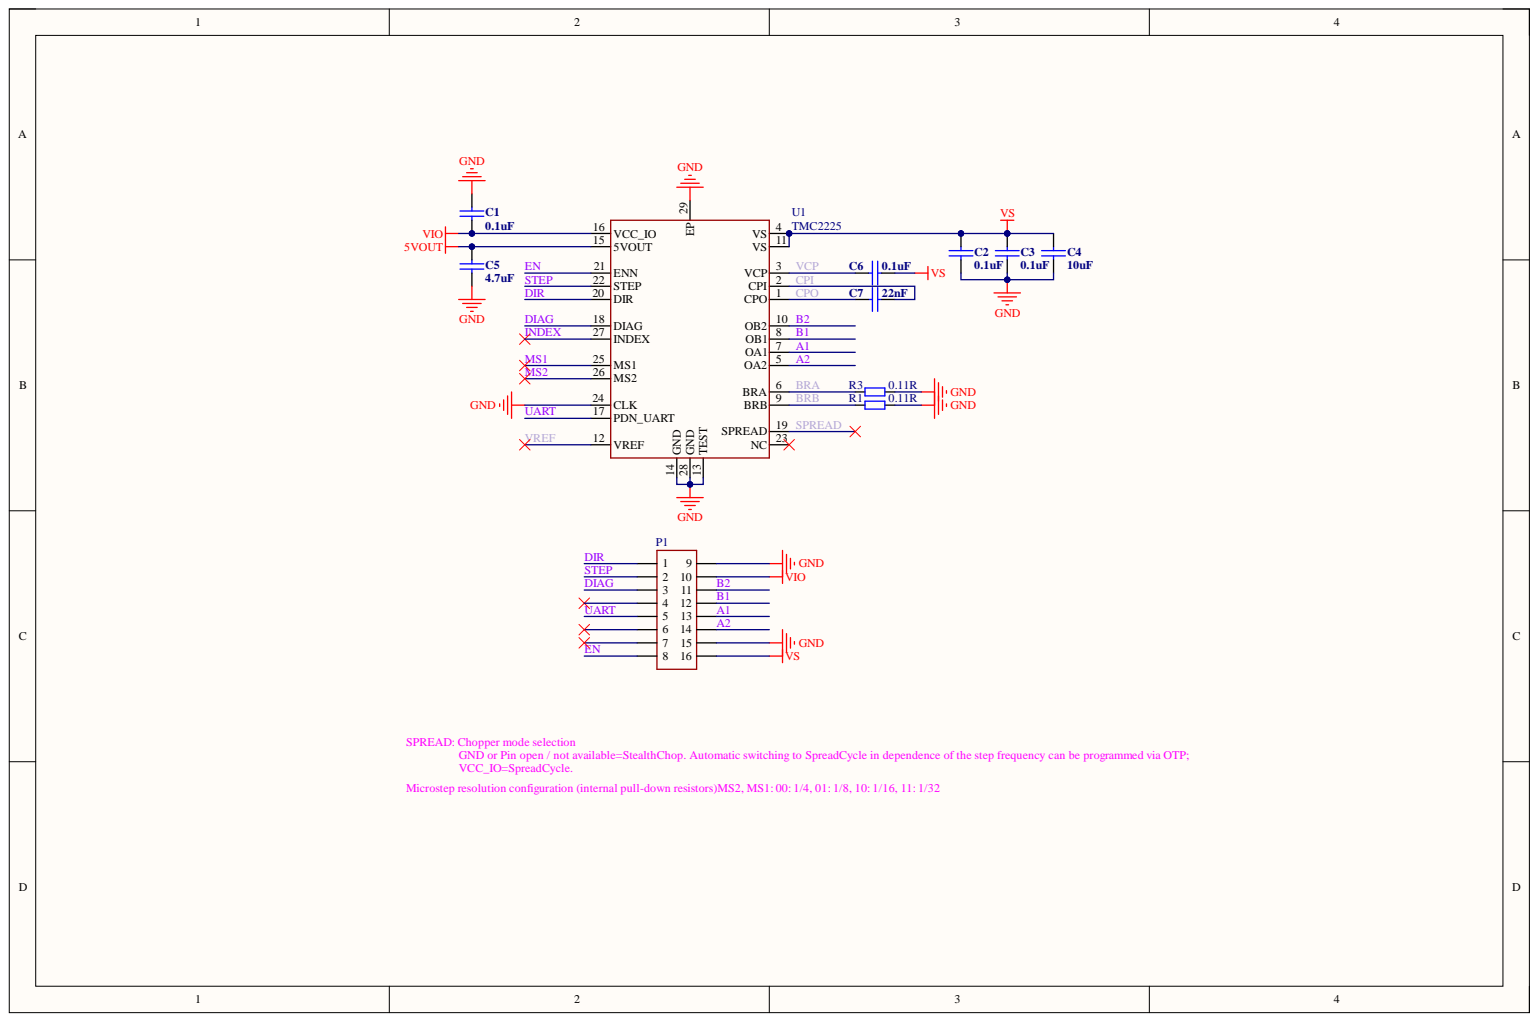
[picture p41: page 1]

uency can be pro
